mtilocca/sprinkler-valve-controller/README.md

# Sprinkler Valve Controller — ESP32-S3, 12 V in, 4 valves, isolated RS485

**Status:** Rev C (adds LoRa): schematic ERC clean, board routed and DRC clean (0 errors, 0 unconnected), fab files generated. Order in progress. This project is the simplified successor of the MPPT board (`../sprinkler-mppt-pcb`): PV and MPPT moved to a separate module.

## What it is

A small board that runs 4 sprinkler valves from a 12 V supply (battery, the PV/MPPT module, or a wall adapter; never above 15 V).

- **ESP32-S3-WROOM-1-N8**, firmware on Zephyr RTOS
- **4 valve outputs** (12 V, up to 1 A each, at most 2 on at once)
- **LoRa EU868** (Ebyte E22-900M22S, SX1262), single-channel gateway for your own sensors
- **WiFi and Bluetooth LE** from the ESP32-S3 module
- **Isolated RS485** (CA-IS3092W) for Modbus RTU
- **USB-C** for flashing, BOOT and RESET buttons, debug header, 4 LEDs
- **12 V monitor** into the ESP32 ADC, so the firmware can stop the valves on a low battery
- **Input protection:** resettable fuse, reverse-polarity P-FET, TVS

Target board: 100 × 60 mm, 2 layers, all SMT parts on the top, only screw terminals and headers through-hole.
Radio: Ebyte E22-900M22S (SX1262, EU 868 MHz) single-channel LoRa gateway radio with a u.FL antenna connector, see docs/08-fabrication.md (Rev C).

## Documents

| File | Content |
|---|---|
| [docs/01-requirements.md](docs/01-requirements.md) | Requirements and assumptions |
| [docs/02-hardware.md](docs/02-hardware.md) | Power tree, valves, RS485, USB-C, protection |
| [docs/03-pinmap.md](docs/03-pinmap.md) | ESP32-S3 GPIO map |
| [docs/04-firmware.md](docs/04-firmware.md) | Firmware notes |
| [docs/06-bringup.md](docs/06-bringup.md) | Bring-up and test plan |
| [docs/07-parts-check.md](docs/07-parts-check.md) | Web check of the risky parts, LCSC numbers, risks |
| [docs/08-fabrication.md](docs/08-fabrication.md) | JLCPCB order settings, files, checks |
| [docs/09-shopping-list.md](docs/09-shopping-list.md) | Hand-soldered parts and other things to buy |
| [docs/10-board-layout.md](docs/10-board-layout.md) | Board layout, capabilities, layout rules, bring-up notes |
| [hardware/README.md](hardware/README.md) | How the schematic and board are generated |

## Schematic

PDF: [hardware/valve_controller_schematic.pdf](hardware/valve_controller_schematic.pdf). Generated from `hardware/valve_controller.py` (SKiDL); open `hardware/valve_controller.kicad_pro` in KiCad.

| Sheet | Content |
|---|---|
| `power_in` | 12 V terminal, fuse, reverse-polarity P-FET, TVS, 12 V monitor divider |
| `aux_power` | AP63205 5 V buck, USB 5 V OR, AMS1117-3.3 LDO (22 µF tantalum output) |
| `esp32` | ESP32-S3 module, BOOT and RESET, debug header |
| `usb_c` | USB-C connector, CC resistors, ESD protection |
| `lora` | E22-900M22S LoRa module, decoupling, u.FL antenna connector |
| `valves` | 4 × AO3400A drivers with flyback diodes, screw terminals, bulk capacitor |
| `rs485` | CA-IS3092W, TVS, termination and bias jumpers, terminal |
| `leds` | 4 LEDs and resistors |
| `test_points` | V12, 5V, 3V3, GND |

## Board

Open `hardware/valve_controller.kicad_pcb` (or the project `hardware/valve_controller.kicad_pro`) in KiCad 10. Layout notes: [docs/10-board-layout.md](docs/10-board-layout.md).

### 3D views

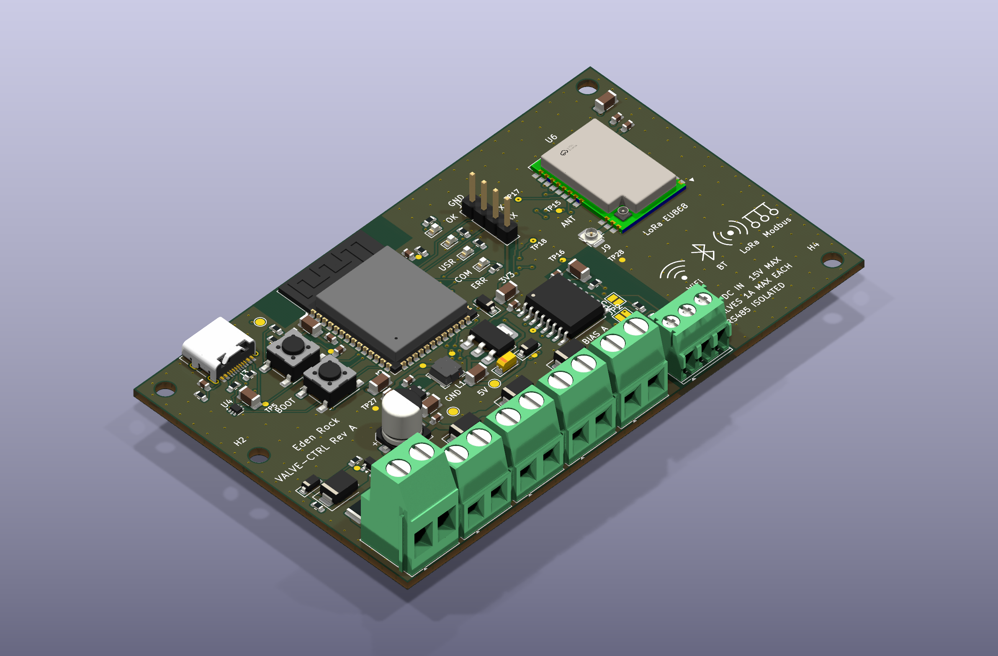
[picture p1: docs/images/board-3d-iso-revc.png]
3D view, isometric


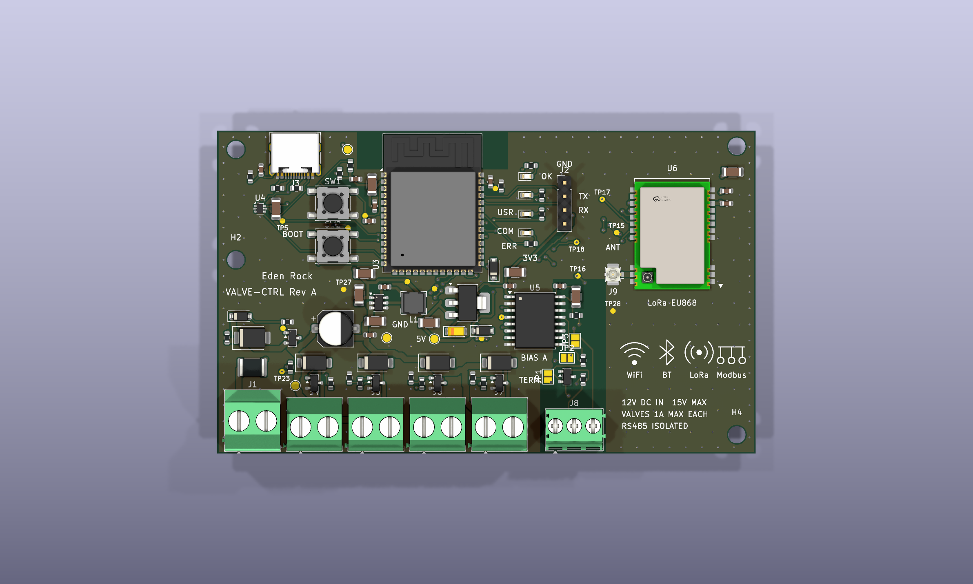
[picture p2: docs/images/board-3d-top-revc.png]
3D view, top


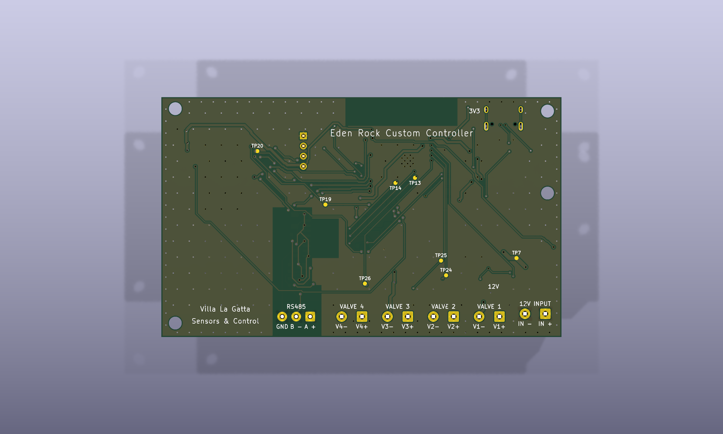
[picture p3: docs/images/board-3d-bottom-revc.png]
3D view, bottom


### Layout

Top side with silkscreen:

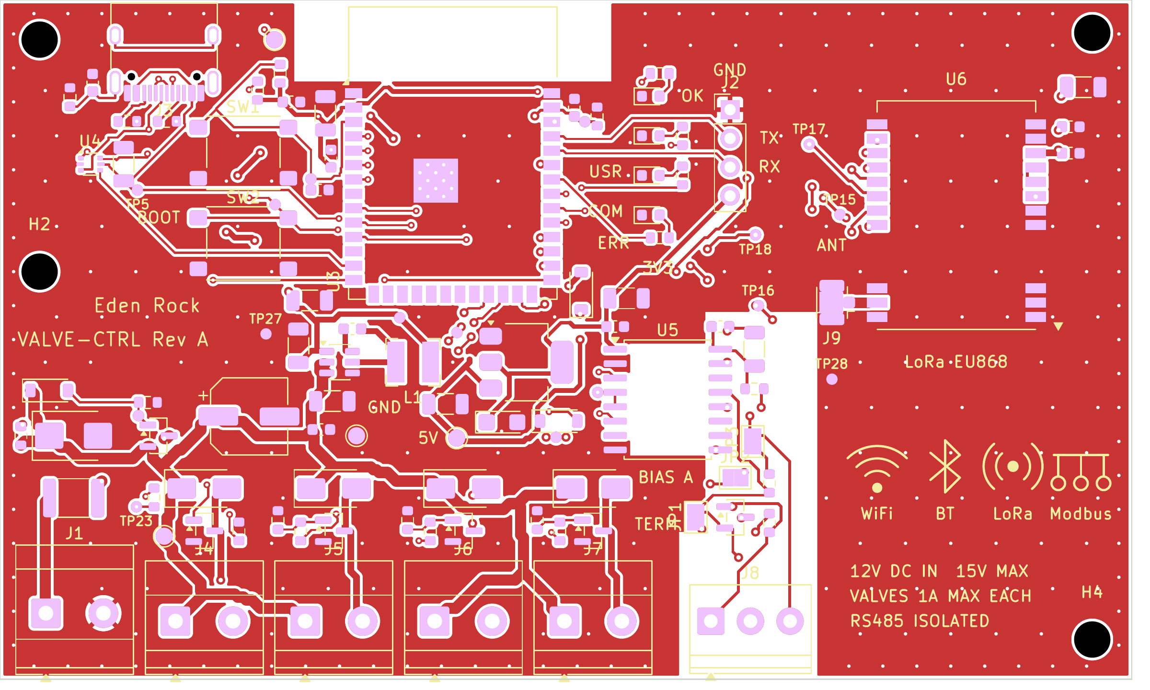
[picture p4: docs/images/board-layout-top-revc.png]
Board layout, top


Both copper layers (red = top, blue = bottom, GND pours on both):

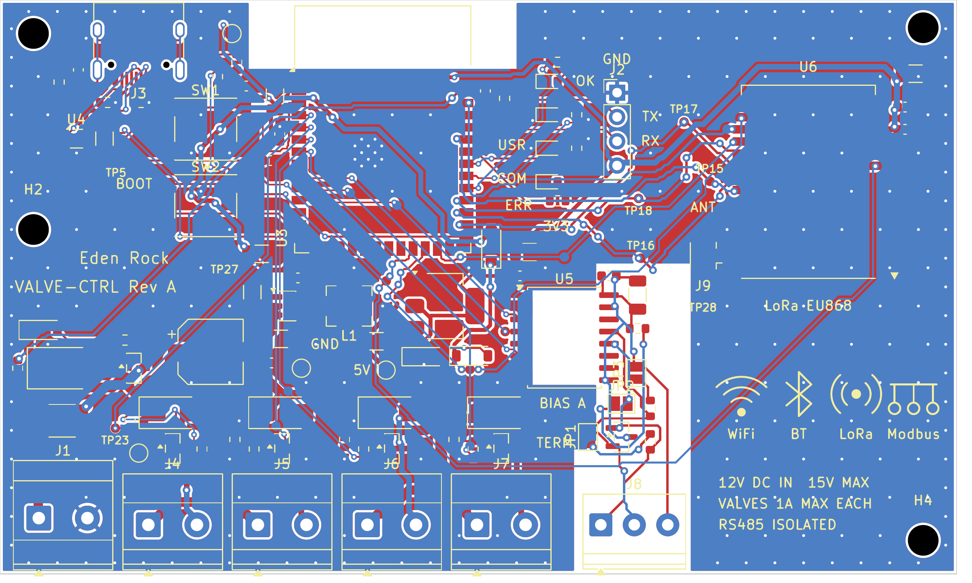
[picture p5: docs/images/board-copper-revc.png]
Copper layers


### Schematic sheets

The schematic is generated label-only (nets are connected by name, see `hardware/README.md`). Full PDF: [hardware/valve_controller_schematic.pdf](hardware/valve_controller_schematic.pdf).

| Sheet | Image |
|---|---|
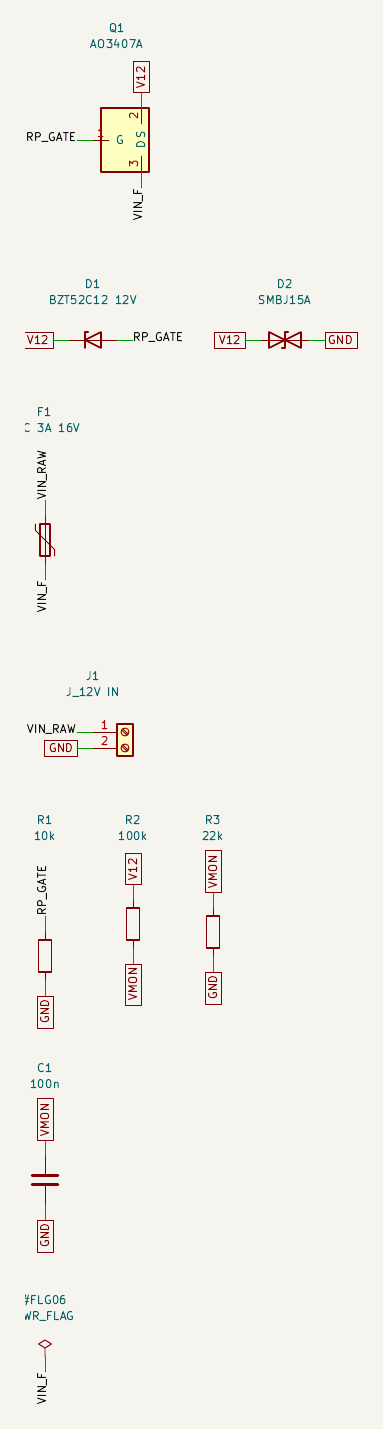
[picture p6: docs/images/schematic-power_in.png]
power_in
| `power_in` |  |
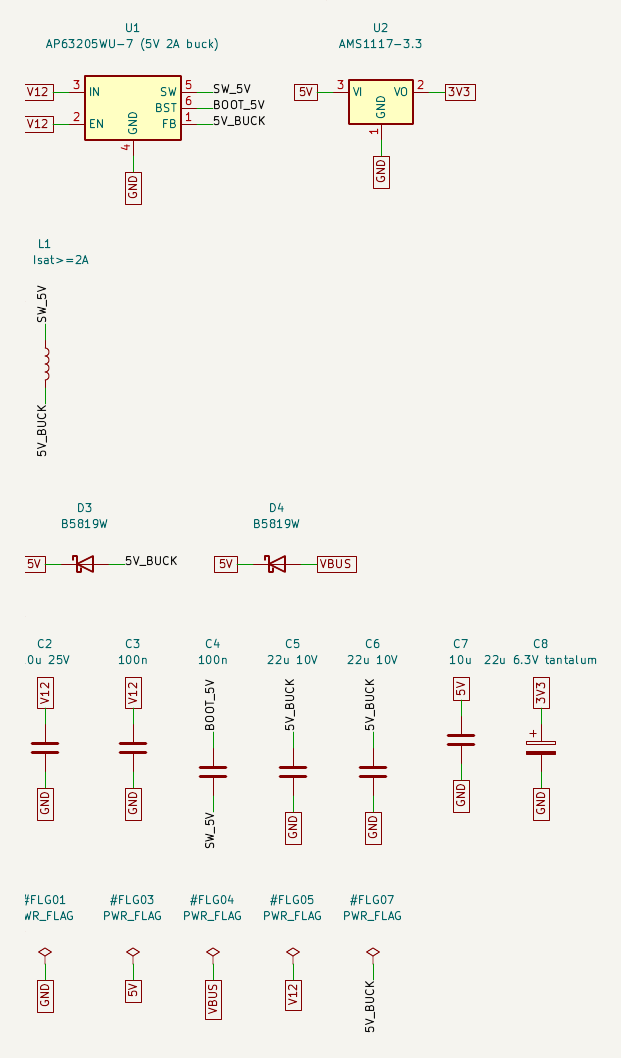
[picture p7: docs/images/schematic-aux_power.png]
aux_power
| `aux_power` |  |
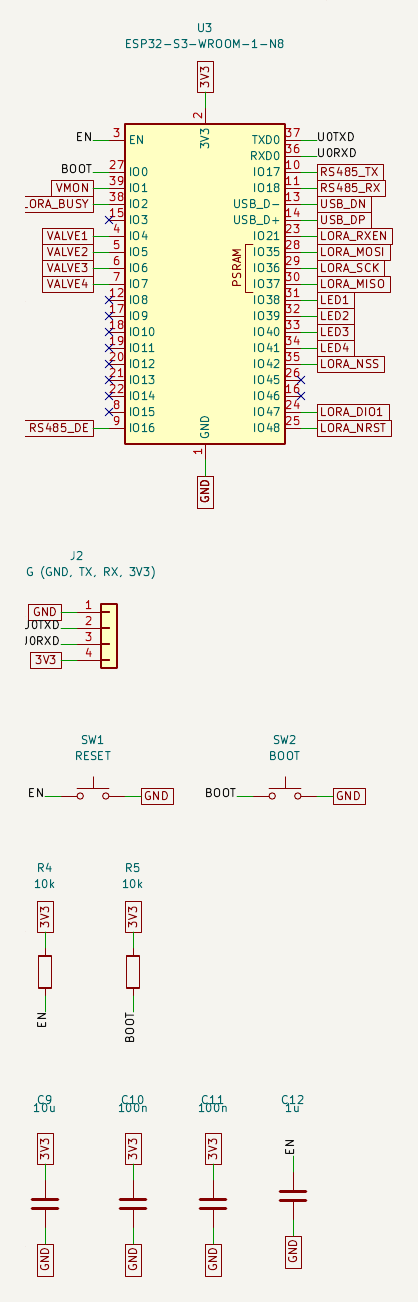
[picture p8: docs/images/schematic-esp32.png]
esp32
| `esp32` |  |
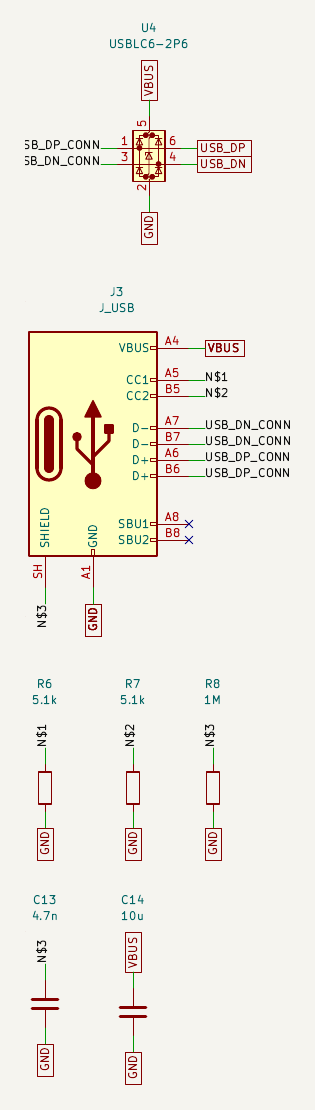
[picture p9: docs/images/schematic-usb_c.png]
usb_c
| `usb_c` |  |
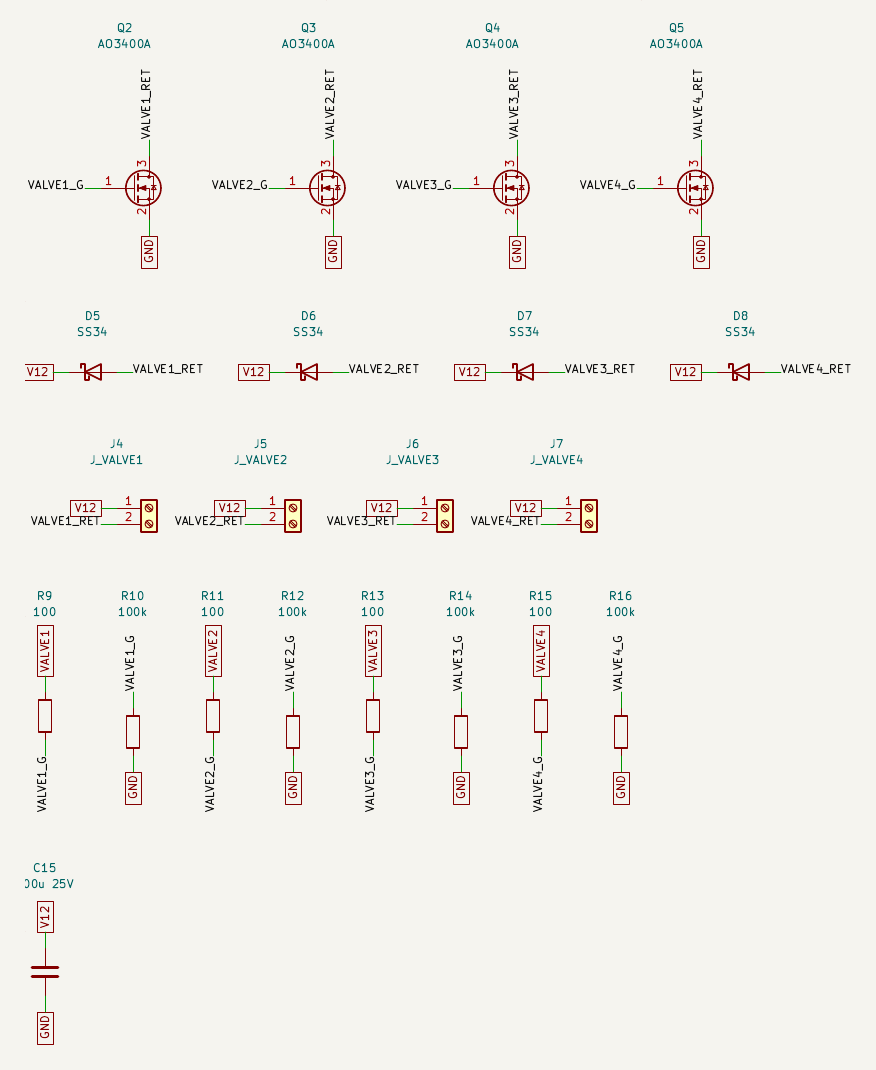
[picture p10: docs/images/schematic-valves.png]
valves
| `valves` |  |
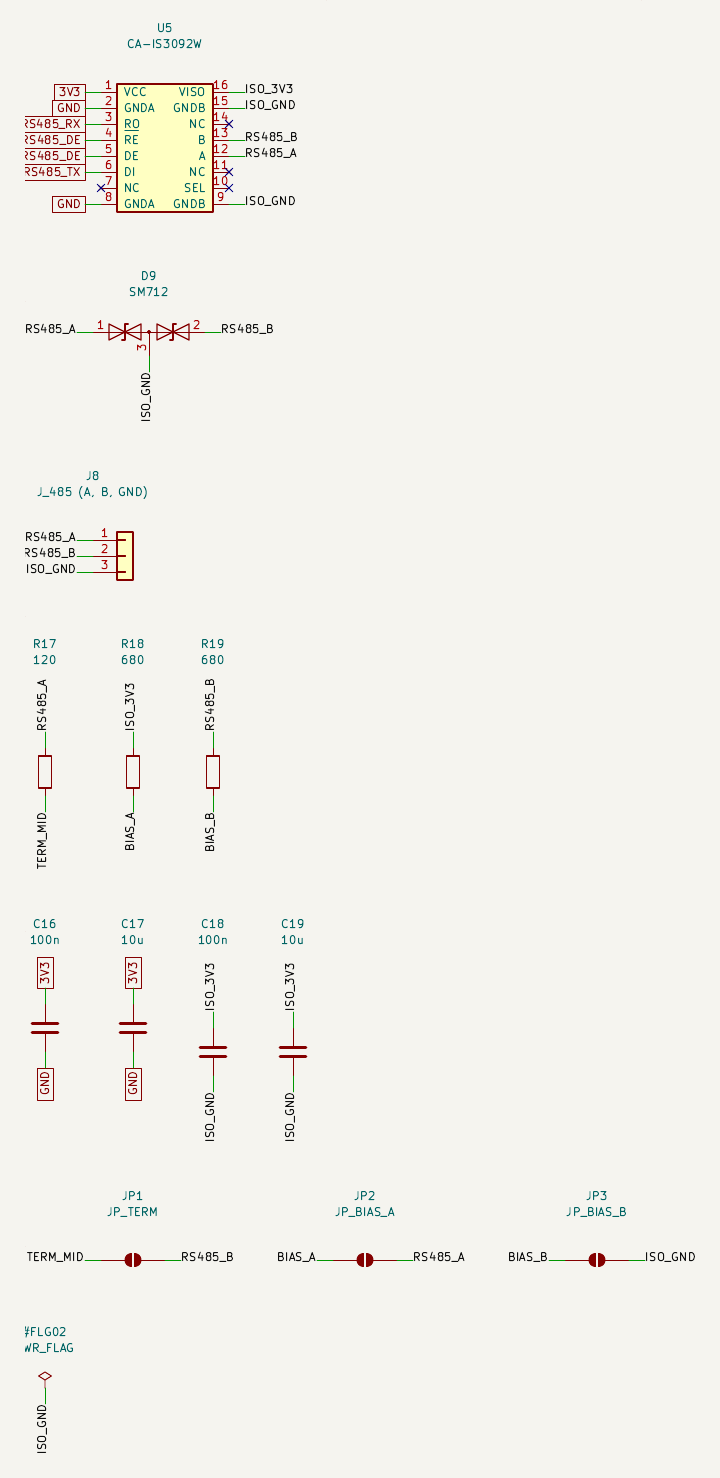
[picture p11: docs/images/schematic-rs485.png]
rs485
| `rs485` |  |
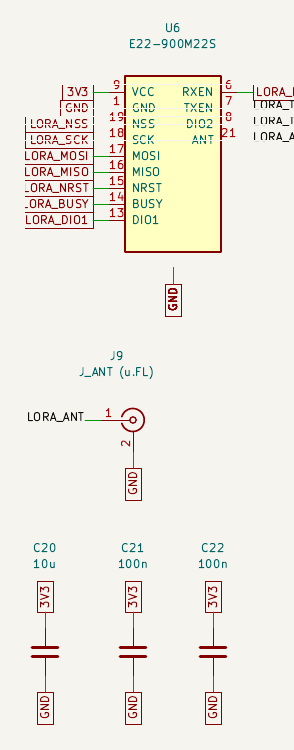
[picture p12: docs/images/schematic-lora.png]
lora
| `lora` |  |
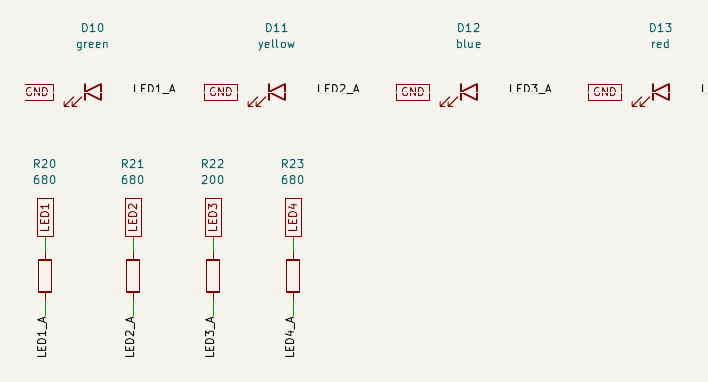
[picture p13: docs/images/schematic-leds.png]
leds
| `leds` |  |
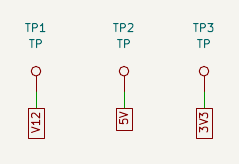
[picture p14: docs/images/schematic-test_points.png]
test_points
| `test_points` |  |

## Fabrication specs

| Item | Value |
|---|---|
| Size | 100 x 60 mm, 4 x M3 mounting holes |
| Layers | 2, GND pour on both layers with stitching vias |
| Copper, finish | 1 oz, HASL lead-free (ENIG optional) |
| Track and space | 0.2 / 0.2 mm; V12 rail 1.0 mm, valve returns 0.6 mm, 5 V rails 0.5 mm |
| Vias | 0.6 / 0.3 mm |
| Antenna area | No copper in the strip at the top edge around the ESP32 antenna |
| RS485 isolation | Bus side right of the isolator: no GND pour, nothing under the chip body between the pin rows (about 7 mm) |
| Assembly | One side (top), SMT by JLCPCB; screw terminals and the debug header soldered by hand |
| Checks | ERC 0 violations; DRC 0 errors, 0 unconnected |

Files in `hardware/fab/`: `gerbers_valve_controller_RevC.zip` (and `gerber/`), `BOM_valve_controller.csv` (draft with suggested parts and rough prices), `BOM_JLCPCB_import.csv` (LCSC numbers to fill), `CPL_valve_controller.csv` (SMD positions, top side).

## Costs

**Rough estimates from memory, not quotes.** Upload the files to the JLCPCB quote page for real numbers. USD.

| Item | Estimate |
|---|---|
| Components per board | about 14 (84 parts, 15 of the BOM lines are JLCPCB "extended" parts) |
| 5 bare 2-layer boards | about 2-8 |
| Shipping | 15-25 |
| JLCPCB SMT assembly fees (one side) | about 55-65 (setup, stencil, about 3 per extended part type) |
| **5 boards assembled by JLCPCB** (terminals and header soldered by hand) | **about 150-180, roughly 30-35 per board** |
| **2 boards assembled** | about 100-120 |
| **2 boards built entirely by hand** | about 50-70 (boards, shipping, parts) |

Open items before ordering: confirm stock and basic/extended class on the JLCPCB parts pages for the LCSC numbers in the BOM (see docs/07-parts-check.md), especially the LDO (low stock seen); the PTC fuse hold current drops when hot; two small silkscreen labels did not fit (RESET, BIAS B); terminal polarity labels are on the bottom side, next to the pads.
