mtilocca/sprinkler-valve-controller/hardware/erc_report.txt

ERC report (2026-11-01T22:34:55, Encoding UTF8)
Report includes: Errors, Warnings, Exclusions

***** Sheet /

***** Sheet /power_in/

***** Sheet /aux_power/

***** Sheet /esp32/

***** Sheet /usb_c/

***** Sheet /valves/

***** Sheet /rs485/

***** Sheet /leds/

***** Sheet /test_points/

***** Sheet /lora/

 ** ERC messages: 0  Errors 0  Warnings 0

 ** Ignored checks:
    - Global label only appears once in the schematic
    - Four connection points are joined together
    - SPICE model issue
    - Assigned footprint doesn't match footprint filters
