mtilocca/sprinkler-valve-controller/hardware/3d/top_render_lora.png

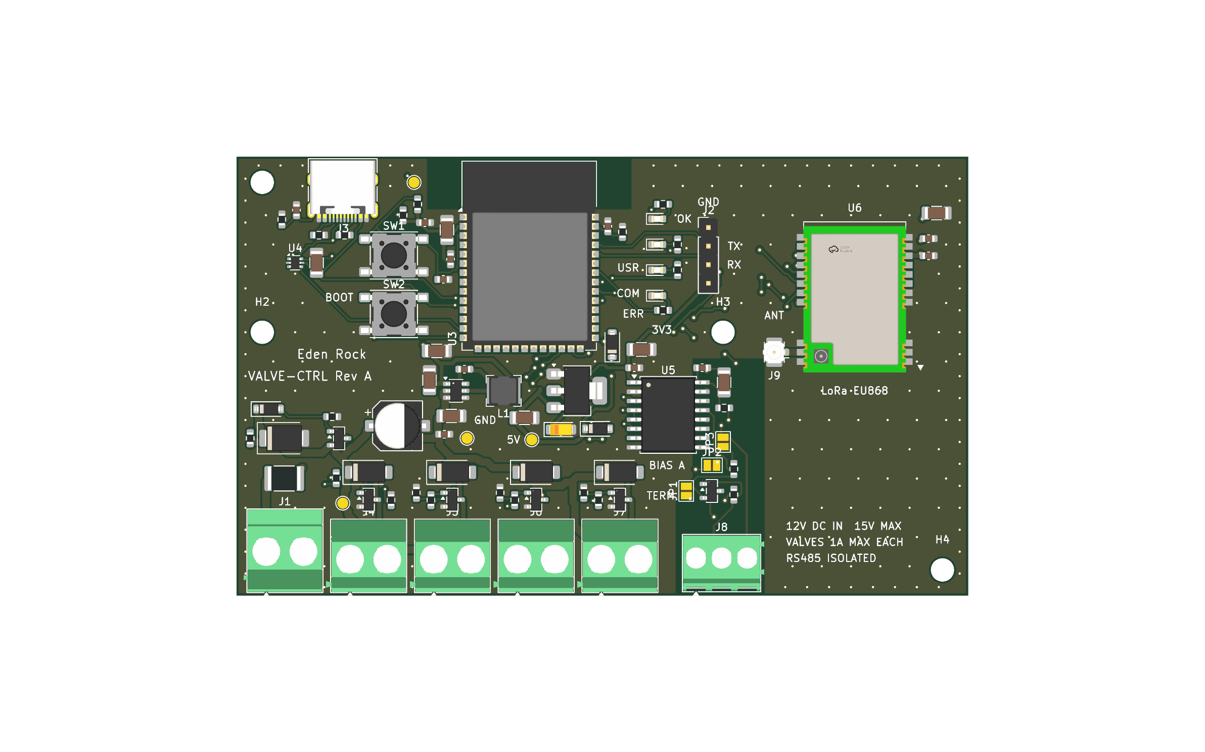
hardware/3d/top_render_lora.png
