mtilocca/sprinkler-valve-controller/hardware/3d/top_render_with_usb.png

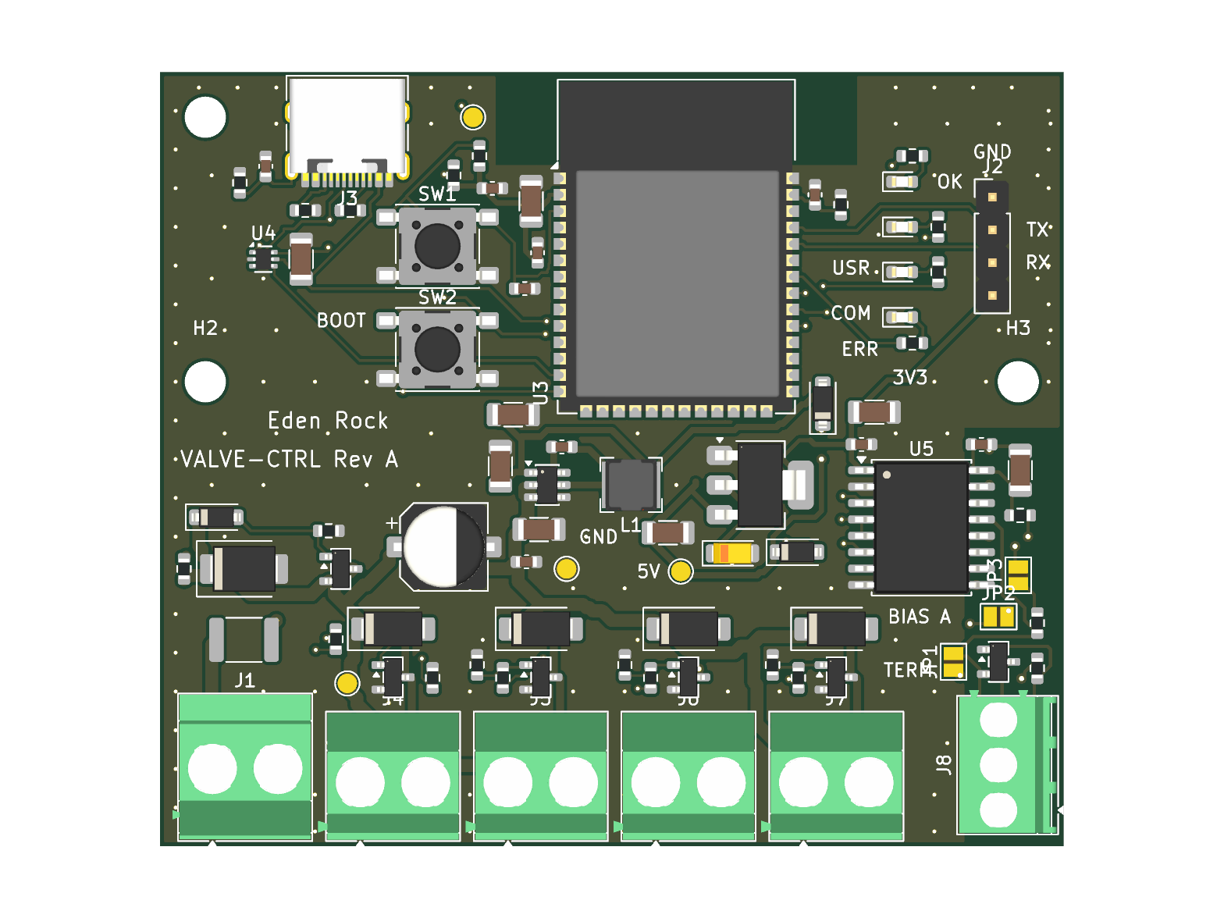
hardware/3d/top_render_with_usb.png
