mtilocca/sprinkler-valve-controller/hardware/fab/BOM_JLCPCB_import.csv

Comment | Designator | Footprint | LCSC Part #
100n | C1,C3,C4,C10,C11,C16,C18,C21,C22 | C_0603_1608Metric | C14663
10u 25V | C2 | C_1206_3216Metric | C13585
22u 10V | C5,C6 | C_1206_3216Metric | C12891
10u | C7,C9,C14,C17,C19,C20 | C_1206_3216Metric | C13585
22u 6.3V tantalum | C8 | CP_EIA-3216-18_Kemet-A | C11366
1u | C12 | C_0603_1608Metric | C15849
4.7n | C13 | C_0603_1608Metric | C53987
100u 25V | C15 | CP_Elec_6.3x7.7 | C72478
BZT52C12 12V | D1 | D_SOD-123 | C19077410
SMBJ15A | D2 | D_SMB | C188412
B5819W | D3,D4 | D_SOD-123 | C64885
SS34 | D5,D6,D7,D8 | D_SMA | C8678
SM712 | D9 | SOT-23 | C5364052
green | D10 | LED_0603_1608Metric | C12624
yellow | D11 | LED_0603_1608Metric | C2287
blue | D12 | LED_0603_1608Metric | C2288
red | D13 | LED_0603_1608Metric | C2286
PTC 3A 16V | F1 | Fuse_1812_4532Metric | C6851473
J_USB | J3 | USB_C_Receptacle_HRO_TYPE-C-31-M-12 | C165948
J_ANT (u.FL) | J9 | U.FL_Hirose_U.FL-R-SMT-1_Vertical | C88374
4.7u Isat>=2A | L1 | L_Bourns-SRN4018 | C167806
AO3407A | Q1 | SOT-23 | C347478
AO3400A | Q2,Q3,Q4,Q5 | SOT-23 | C20917
10k | R1,R4,R5 | R_0603_1608Metric | C25804
100k | R2,R10,R12,R14,R16 | R_0603_1608Metric | C25803
22k | R3 | R_0603_1608Metric | C31850
5.1k | R6,R7 | R_0603_1608Metric | C23186
1M | R8 | R_0603_1608Metric | C22935
100 | R9,R11,R13,R15 | R_0603_1608Metric | C22775
120 | R17 | R_0603_1608Metric | C22787
680 | R18,R19,R20,R21,R23 | R_0603_1608Metric | C23228
200 | R22 | R_0603_1608Metric | C8218
RESET | SW1 | SW_SPST_PTS645Sx43SMTR92 | C221880
BOOT | SW2 | SW_SPST_PTS645Sx43SMTR92 | C221880
AP63205WU-7 (5V 2A buck) | U1 | TSOT-23-6 | C2071056
AMS1117-3.3 | U2 | SOT-223-3_TabPin2 | C6186
ESP32-S3-WROOM-1-N8 | U3 | ESP32-S3-WROOM-1 | C2913198
USBLC6-2P6 | U4 | SOT-666 | C2827693
CA-IS3092W | U5 | SOIC-16W_7.5x10.3mm_P1.27mm | C2890051
E22-900M22S | U6 | E22-900M22S | C411293
