mtilocca/sprinkler-valve-controller/hardware/3d/E22-900M22S.step

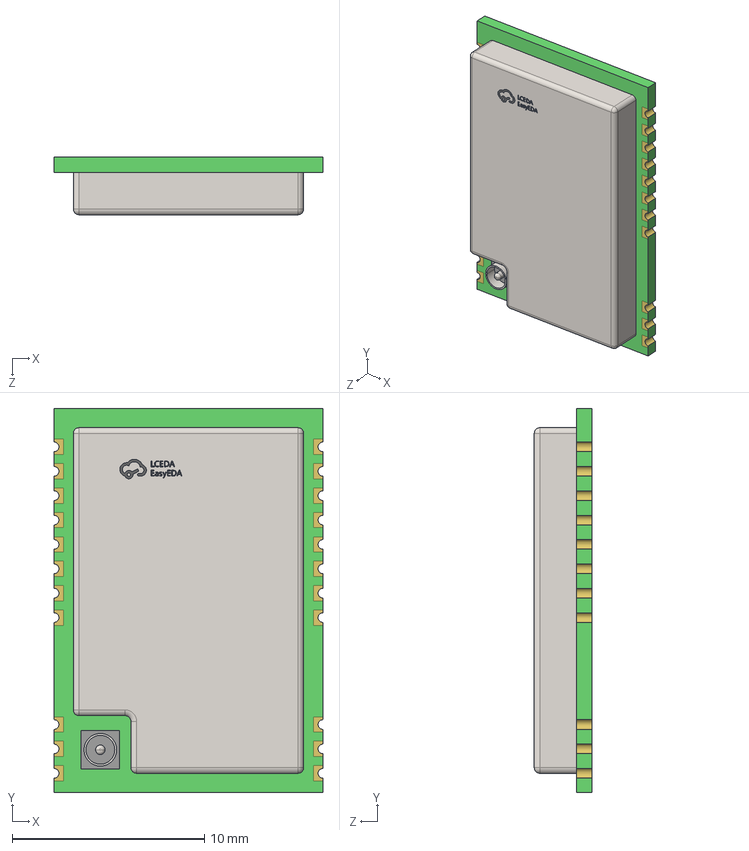
[picture p17: CAD file, 2026-11-01]
hardware/3d/E22-900M22S.step
14.0 x 20.0 x 3.00 mm
