mtilocca/sprinkler-valve-controller/hardware/3d/Fuse_1812_4532Metric.step

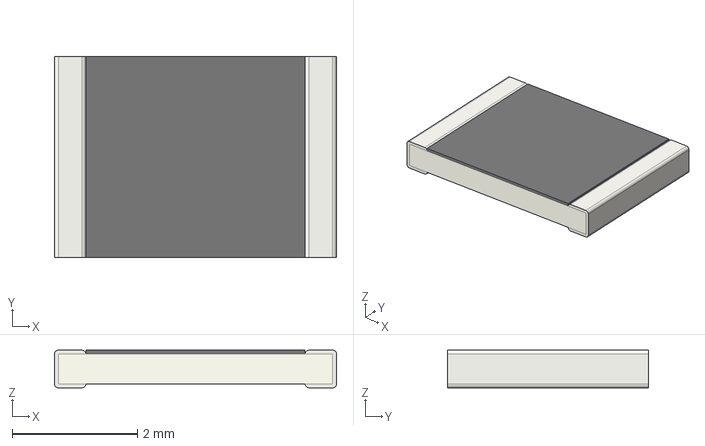
[picture p18: CAD file, 2026-11-01]
hardware/3d/Fuse_1812_4532Metric.step
4.50 x 3.20 x 0.6 mm
