mtilocca/sprinkler-valve-controller/hardware/3d/USB_C_HRO_TYPE-C-31-M-12.step

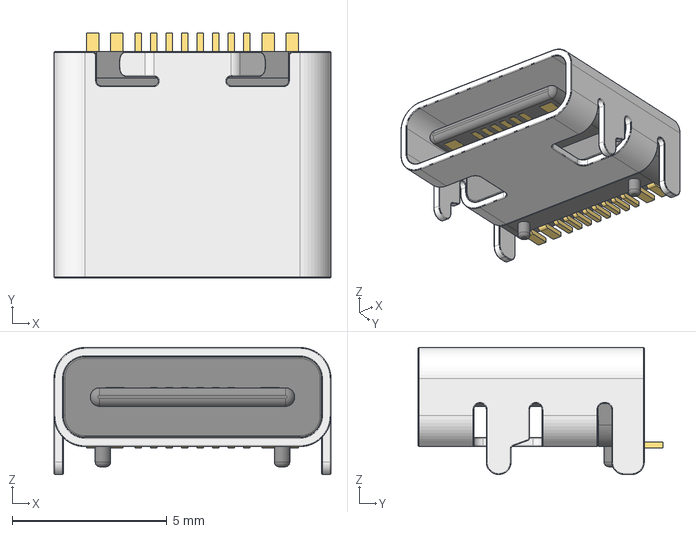
[picture p19: CAD file, 2026-11-01]
hardware/3d/USB_C_HRO_TYPE-C-31-M-12.step
8.94 x 7.90 x 4.10 mm
