mtilocca/sprinkler-valve-controller/docs/08-fabrication.md

# 8. Fabrication and assembly (JLCPCB)

Everything for the order is in `hardware/fab/`.

## Files

| File | Use |
|---|-----|
| `gerbers_valve_controller_RevC.zip` | Upload as the PCB Gerber file (also unpacked in `gerber/`): F.Cu, B.Cu, masks, silkscreen, F.Paste, Edge.Cuts, PTH and NPTH drill |
| `BOM_JLCPCB_import.csv` | Upload as the BOM for assembly: 38 lines, surface-mount parts only (you solder the terminals and header). Ordinary resistors and capacitors have no LCSC number: JLCPCB's matching picks the basic parts |
| `CPL_valve_controller.csv` | Upload as the pick-and-place file: 70 SMD parts, top side |
| `BOM_valve_controller.csv` | Full draft BOM with suggested parts, rough prices and notes (for you, not for upload) |
| `assembly_top.pdf`, `assembly_bottom_labels.pdf` | Assembly drawings: where parts go; terminal labels on the bottom side |
| `valve_controller_schematic.pdf` | Schematic |

## Board settings to choose on the order page

| Setting | Value |
|---|---|
| Base material, layers | FR-4, 2 layers |
| Dimensions | 100 x 60 mm |
| PCB thickness | 1.6 mm |
| Quantity | 5 (smallest panel; the cheapest) |
| Surface finish | HASL lead-free (ENIG optional, small extra cost) |
| Outer copper | 1 oz |
| Solder mask, silkscreen | any colour; white silkscreen |
| Via covering | tented (default) |
| Order number on the board | JLCPCB prints a small order number on the silkscreen; accept the default, or pay the small fee to remove it (there is no placeholder text on this board) |

Board rules used: tracks and gaps 0.2 mm, smallest drill 0.3 mm (the ESP32 pad vias were enlarged from 0.2 to 0.3 mm because 0.2 mm is not available on 2 layers), copper 0.3 mm from the edge, hole to hole 0.5 mm.

## Assembly settings

| Setting | Value |
|---|---|
| PCBA type | **Standard** (the ESP32 module is "Standard only") |
| Assembly side | Top only |
| Quantity | 2 or 5 (minimum 2) |
| Parts | Upload the BOM and CPL. Check every line in JLCPCB's part selection: stock and basic/extended class |
| Through-hole | Not in the BOM or CPL: you solder J1, J4-J7 (5.08 mm terminals), J8 (3.5 mm terminal) and J2 (debug header) yourself: 17 pins per board |
| Solder jumpers | JP1-JP3 stay open (no part) |

## Check in JLCPCB's preview before paying

1. **Part rotations.** JLCPCB's pick-and-place preview shows each part on the board; rotate or flip wrong ones there. The usual suspects are SOT-23 parts (Q1-Q5, D9), the SOT-223 LDO (U2), the SOIC-16 RS485 chip (U5), the TSOT-23-6 buck (U1), the SOT-666 ESD part (U4), the diodes (polarity!) and the ESP32 module (U3).
2. **Stock.** Check C15 (100 µF electrolytic) and D2 (SMBJ15A): both were out of stock on the first match; pick in-stock alternatives (docs/07-parts-check.md). The tantalum C8 (22 µF 6.3 V, 3216) has no LCSC number in the BOM: pick one in the search.
3. **Polarity parts.** Check the cathode side of D1-D8, the zener and the LEDs against `assembly_top.pdf`, and the + side of the electrolytic C15.
4. **Antenna.** The ESP32 antenna end must face the board edge (top edge in the 3D view).

## After the boards arrive

Solder the terminals and header by hand (parts list in docs/09-shopping-list.md), then follow `docs/06-bringup.md`.

## Verified before export

- ERC: 0 violations. DRC: 0 errors, 0 unconnected, schematic parity clean (warnings only for test points, jumpers and mounting holes).
- Outline from the Gerber file: 70.0 x 60.0 mm. Drill file: all plated holes at least 0.3 mm.
- Every part in the CPL is in the BOM; the only BOM lines not in the CPL are the hand-soldered terminals and header.

## CPL correction for U3 (2026-11-01)

In JLCPCB's 3D preview the ESP32 module sat about 4 mm too high (antenna past the board edge, castellations not on the pads). JLCPCB's model origin differs from the KiCad footprint origin, so U3's Y in `CPL_valve_controller.csv` was changed from -13.5 mm to -17.5 mm. The board itself is unchanged. Re-check the preview after uploading the new CPL.

## CPL rotations (2026-11-01)

JLCPCB's models for U2 (SOT-223) and U5 (SOIC-16W) are rotated against the KiCad footprints: U2 set to 180 deg, U5 to 270 deg in the CPL. Verified only against the 3D preview; check pin 1 again after uploading.

## Rev C: LoRa radio (2026-11-02)

New requirement: a LoRa gateway for the sensors around the site (EU 868 MHz). Single-channel only: JLCPCB does not stock SX1302/SX1303 concentrator chips, so this is a private single-channel receiver, not a standards-compliant multi-channel LoRaWAN gateway. Your own sensors must be set to the one channel and data rate that the radio listens on.

- Radio: Ebyte E22-900M22S (SX1262, 868 MHz, 22 dBm), LCSC C411293, SPI plus BUSY, DIO1, NRST and RXEN (see 03-pinmap.md). TXEN and DIO2 are wired together on the module, so the SX1262 drives the RF switch.
- Antenna: u.FL connector J9 (C88374) next to the module, a 2 mm trace from the module's ANT pad. You need a u.FL to SMA pigtail and an 868 MHz antenna. If the module has no signal on the ANT pad, plug the antenna into the module's own IPEX connector instead (the Ebyte datasheet lists both).
- Board: 100 x 60 mm (was 70 x 60), new mounting hole H4 (bottom right), H3 moved from mid-board to the top right corner (96.5, 2.9), E22 module at the right edge, 3V3 decoupling C20-C22.
- ESP32 pins used: GPIO2, 21, 35, 36, 37, 42, 47, 48.
- CPL: U3 was shifted 4 mm in Y, U2 rotated 180 and U5 270 against JLCPCB's models (see above). U6 and J9 are as exported: check them in the preview.
- Files regenerated with `python3 gen_fab.py RevC` (Gerbers, drill, CPL) and `make_bom.py` (BOM).
- DRC: 0 errors, 0 unconnected, schematic parity clean. ERC: 0 violations.
- J8 (RS485 terminal) rotated to face the bottom edge like the valve terminals; pads at x 62.8, 66.3 and 69.8 mm, y 54.9 mm (A, B, GND). The bus-side no-pour area is L-shaped around it. `move_j8.py` did the move. DRC 0 errors, 0 unconnected after the move.

## Pre-order review, 2026-11-02

- Found and fixed: the first LoRa routing ran the SPI lines and the 3V3 feed under the E22 module body (the Ebyte datasheet says to keep traces out from under the module). All eight signals and the 3V3 branch were re-routed around it; the only copper left under the body is GND and the TXEN/DIO2 tie at the pad edge. DRC 0 errors, 0 unconnected, parity clean.
- Checked from the netlist: P-FET reverse-polarity wiring (drain = input, source = load, 12 V zener gate to source, 10 k gate to GND), TVS and zener polarity, 5 V OR-ing diodes, 12 V monitor divider (max 2.7 V at 15 V), ESP32 strapping pins left alone, no floating nets other than the deliberate NC pins.
- Watch at bring-up: (1) on USB power only the 3V3 LDO input is about 4.6 V (5 V minus the Schottky), only about 0.2 V above the AMS1117 dropout at 0.6 A, so a LoRa transmit burst can sag 3V3; (2) the AMS1117 tab has no big copper area, fine for about 0.3 W average; (3) firmware must set DIO2 as RF switch control, RXEN high in receive, DIO3 for the module's TCXO (1.8 V).
