mtilocca/sprinkler-valve-controller/hardware/valve_controller_schematic.pdf

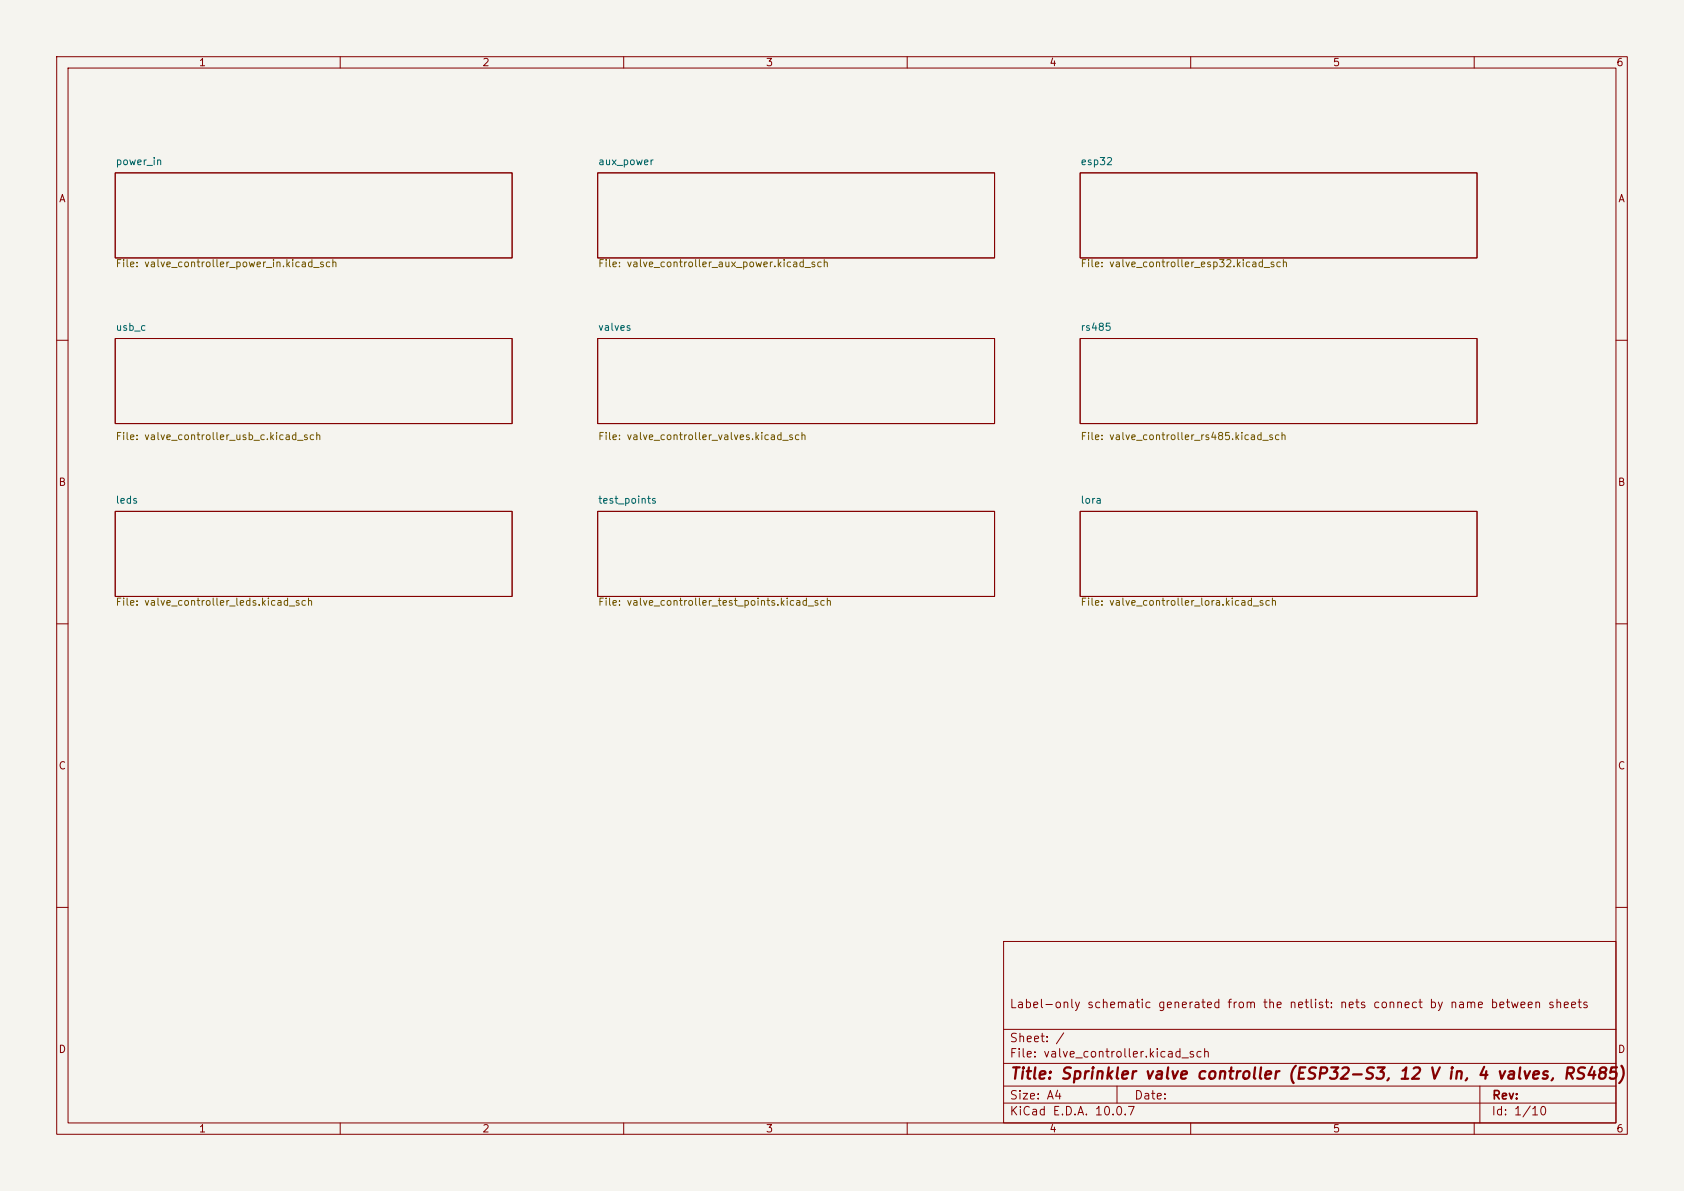
[picture p20: page 1]

Label-only schematic generated from the netlist: nets connect by name between sheets

Sheet: /
File: valve_controller.kicad_sch
Title: Sprinkler valve controller (ESP32-S3, 12 V in, 4 valves, RS485)

Size: A4 | Rev:
KiCad E.D.A. 10.0.7 | Id: 1/10

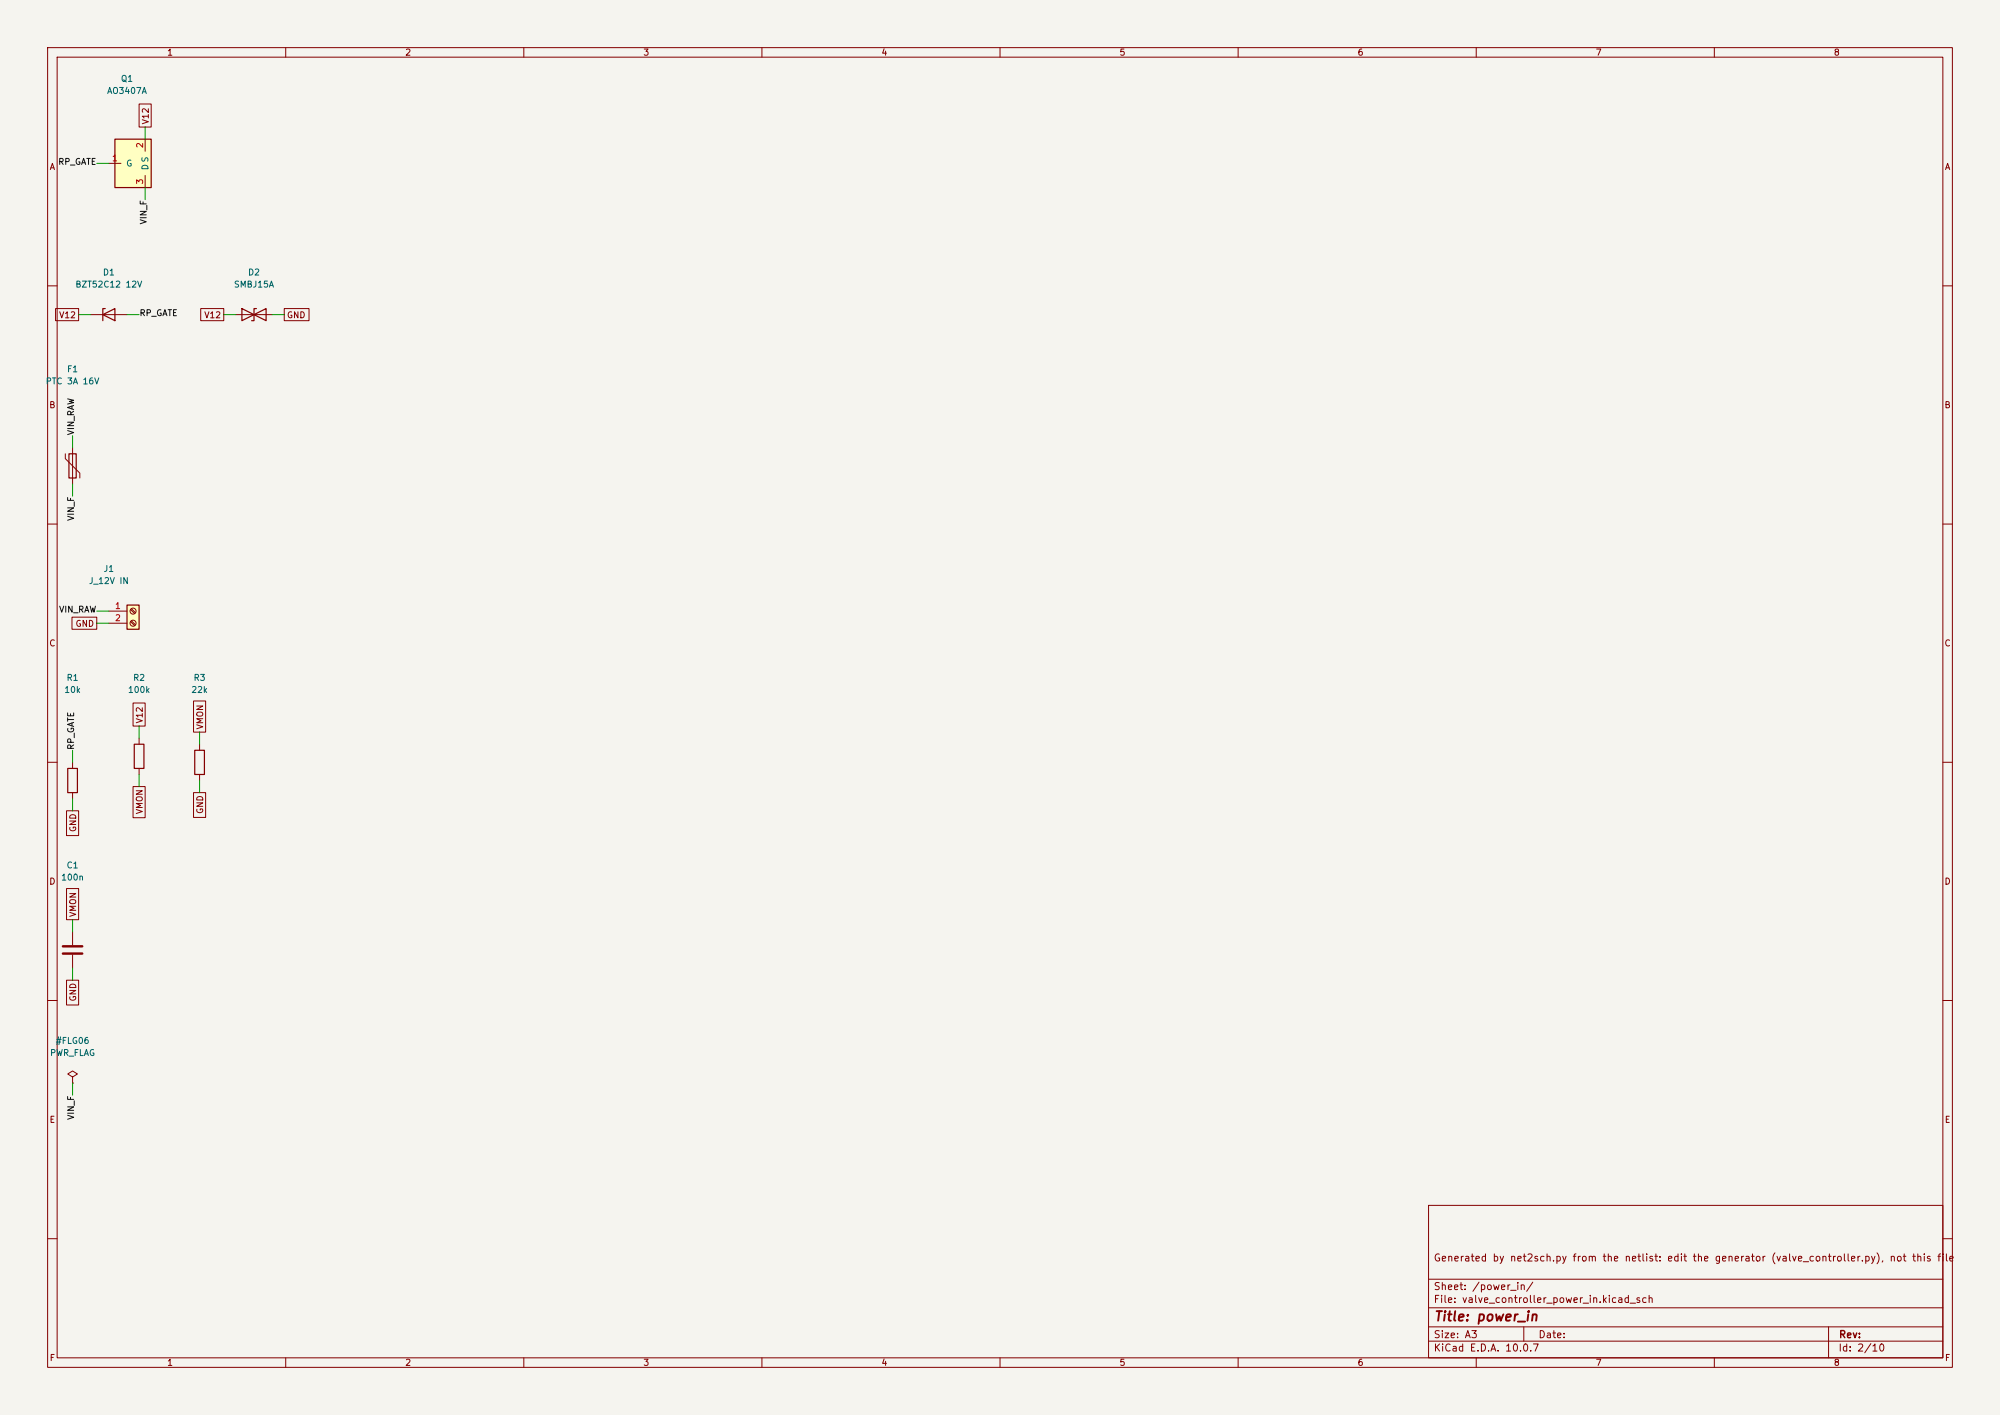
[picture p21: page 2]

Generated by net2sch.py from the netlist: edit the generator (valve_controller.py), not this file

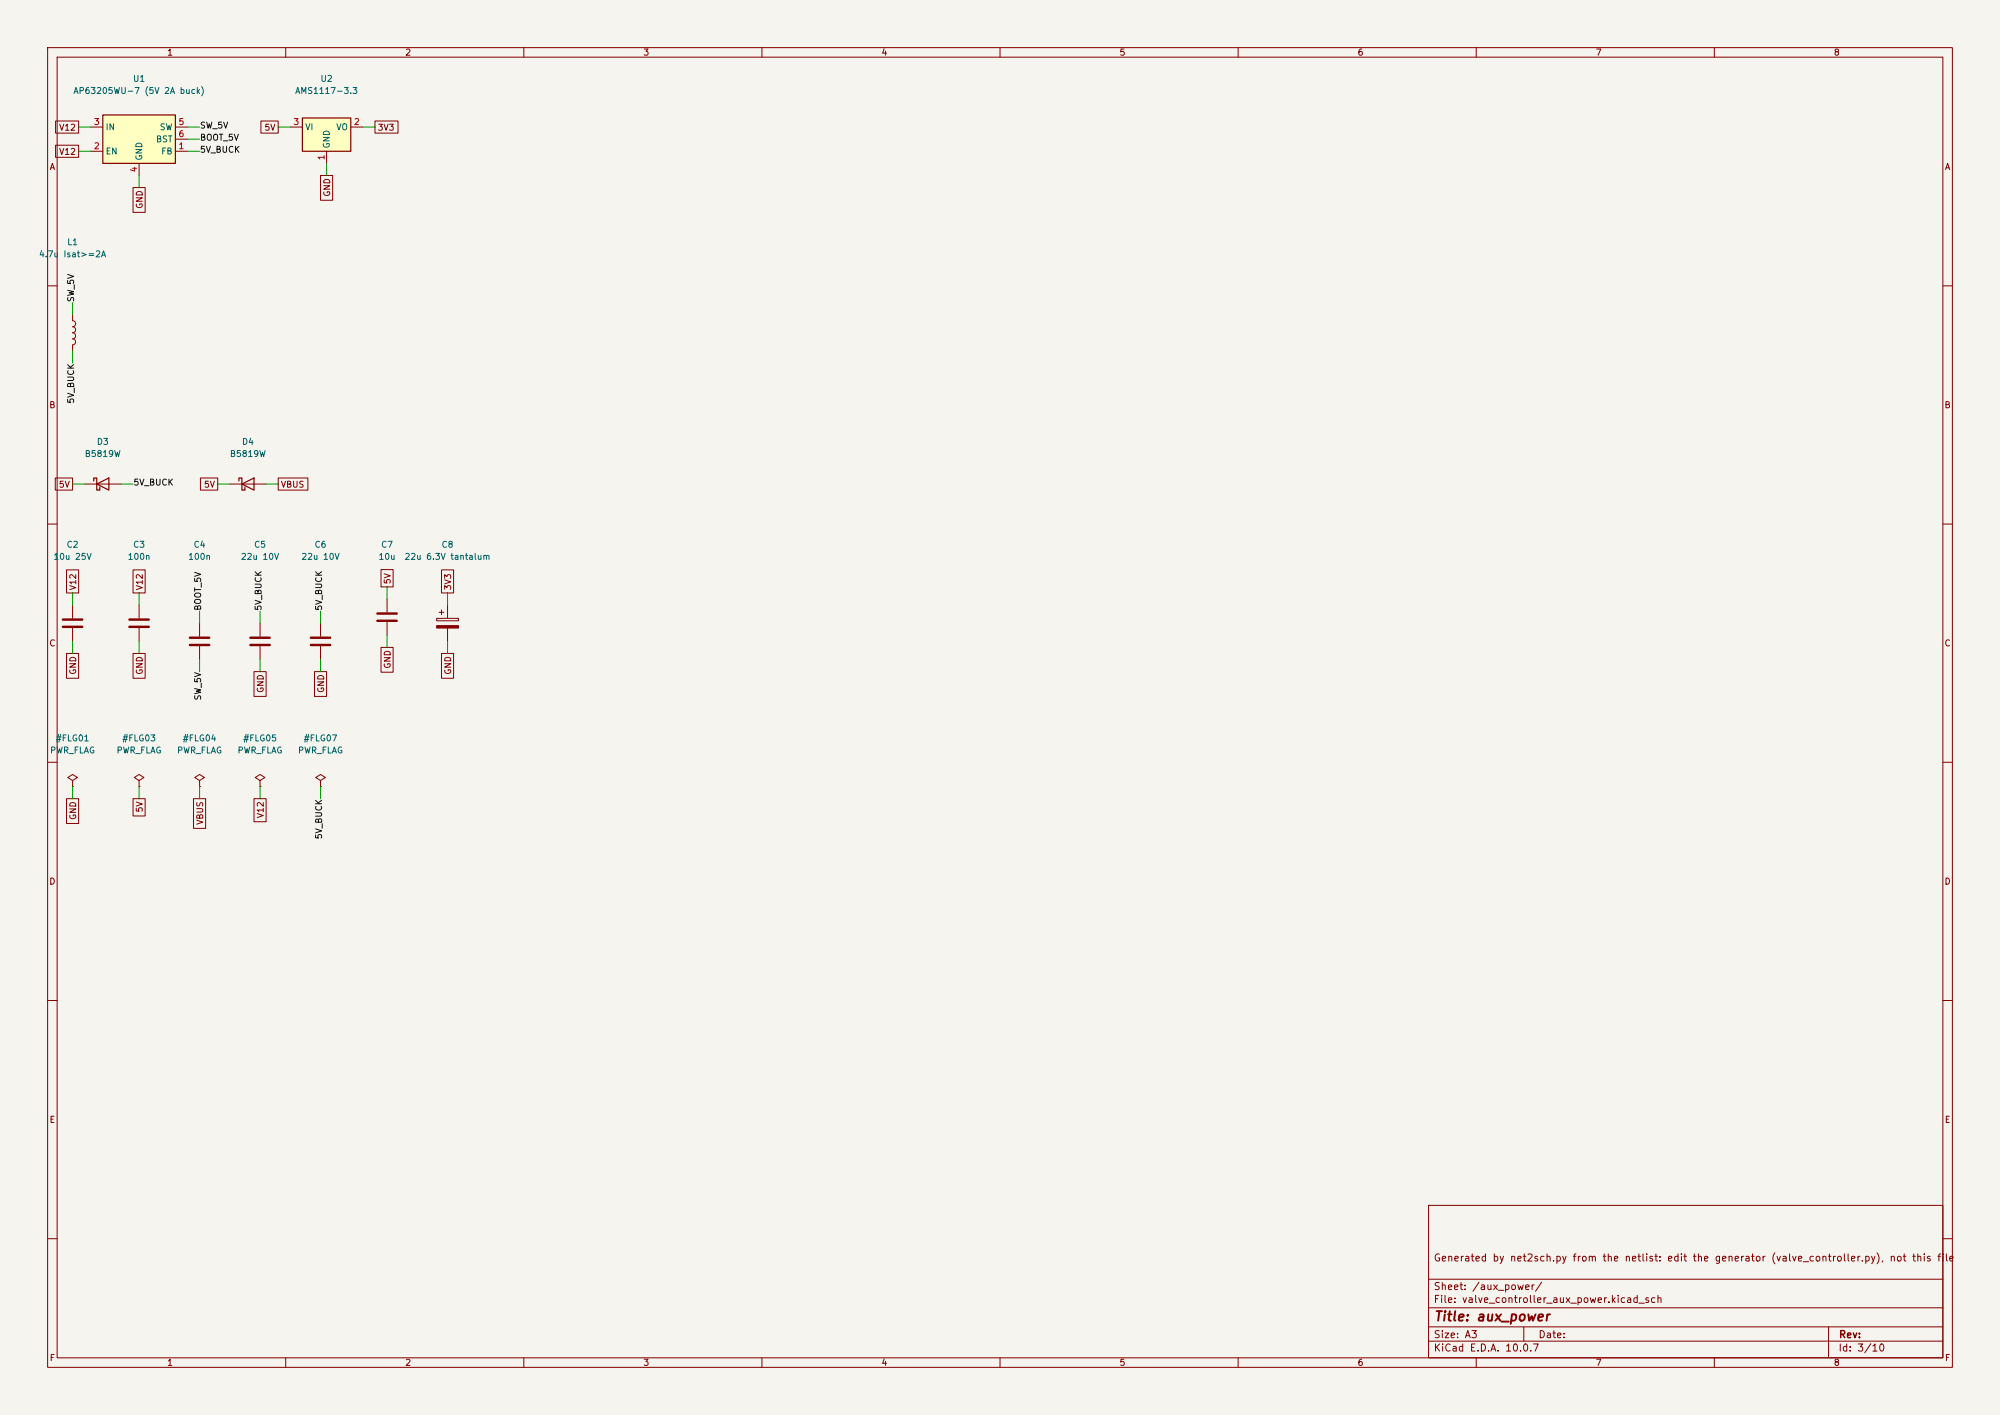
[picture p22: page 3]

Generated by net2sch.py from the netlist: edit the generator (valve_controller.py), not this file

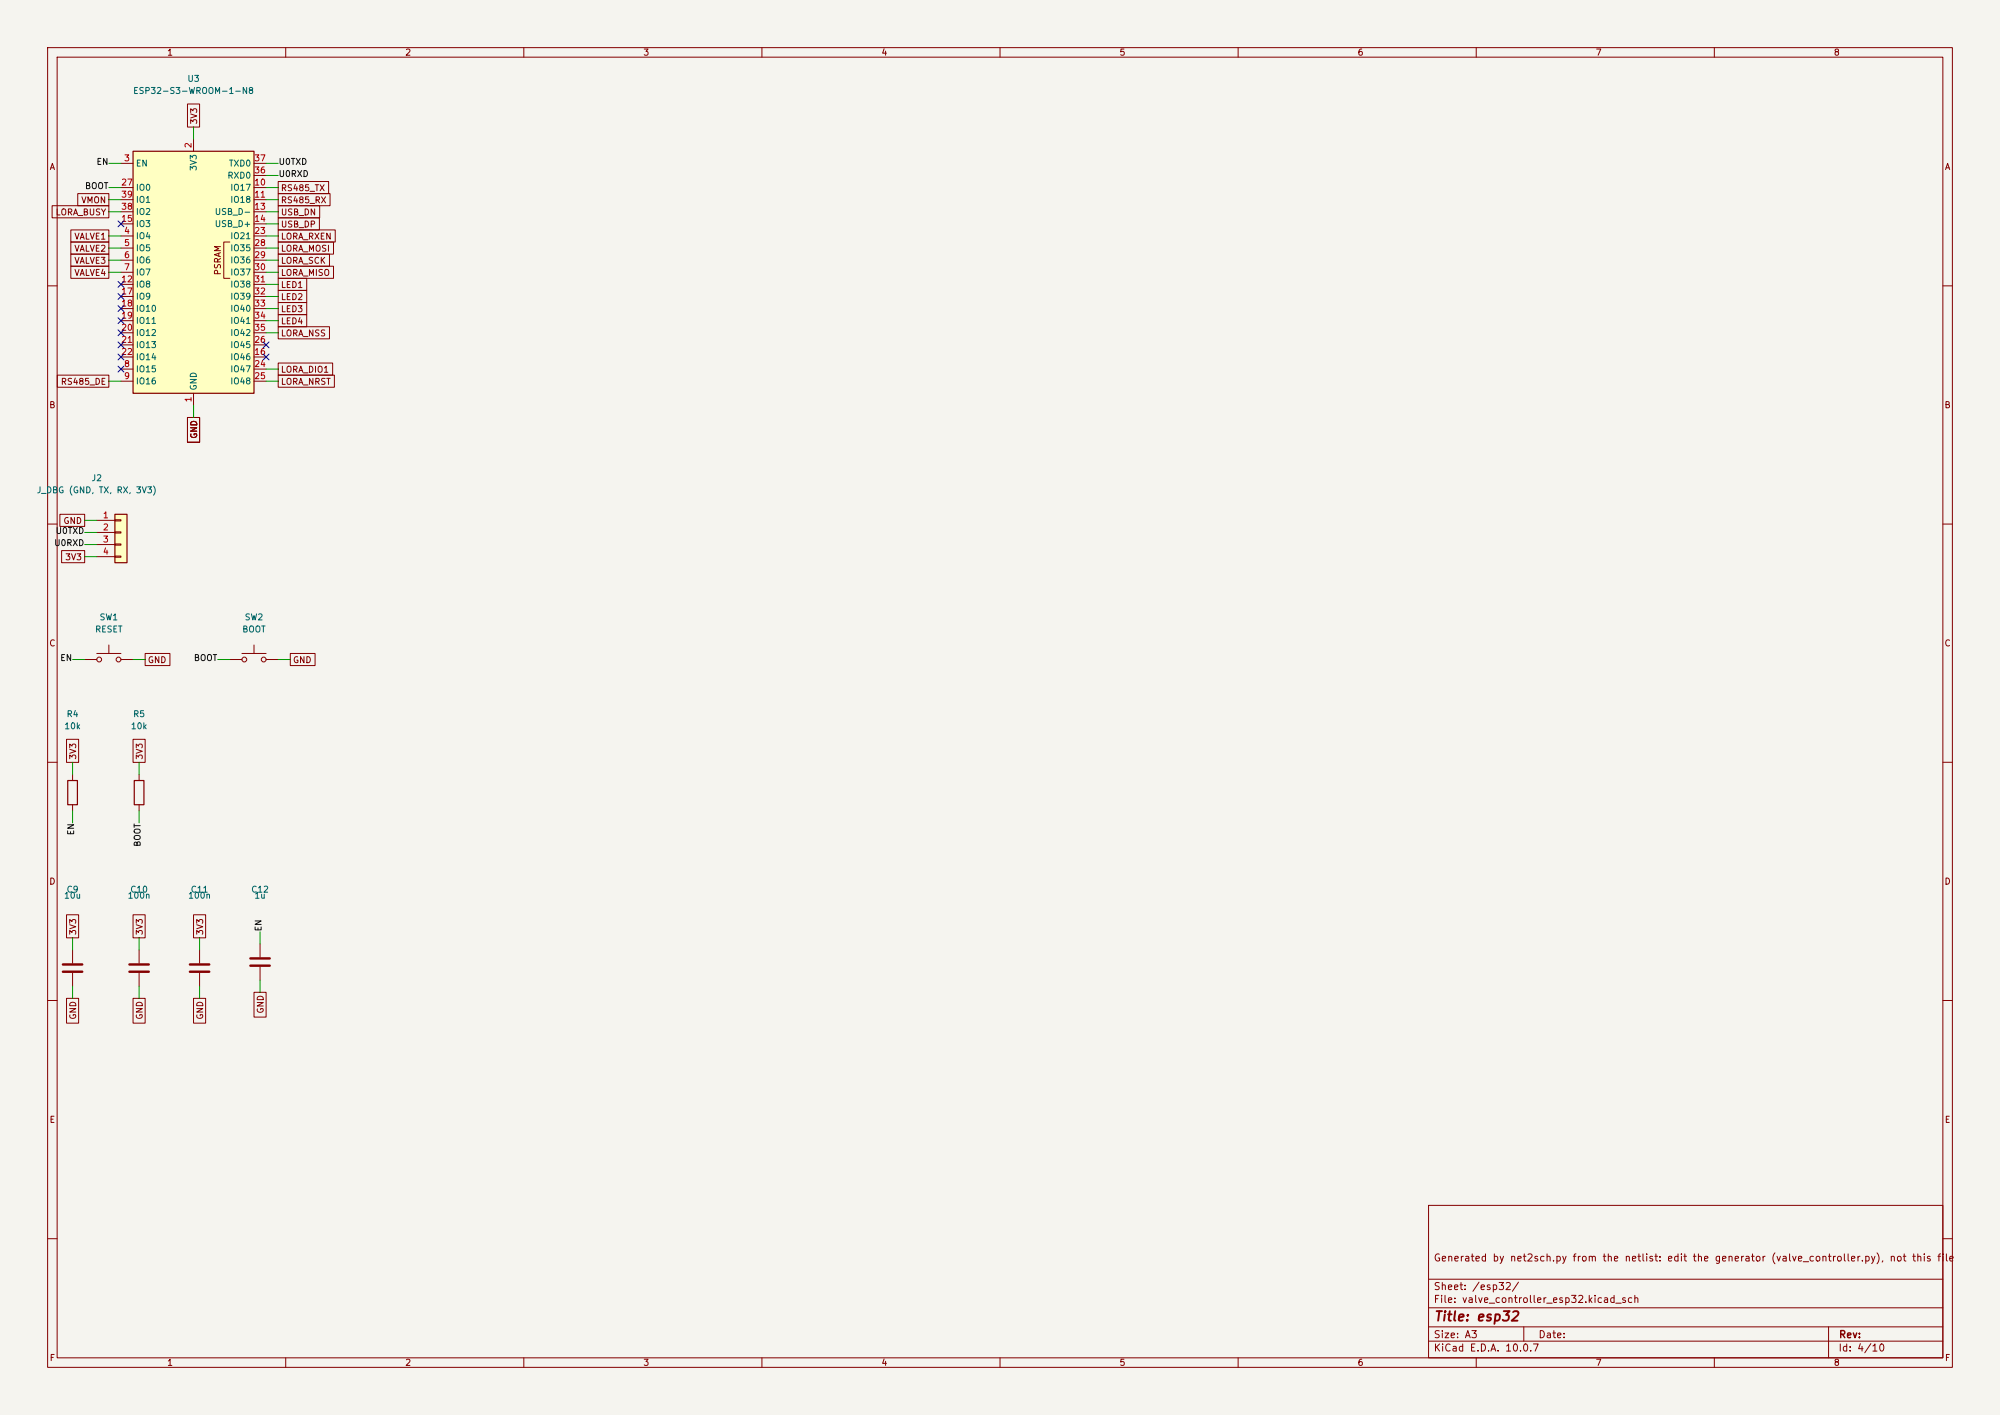
[picture p23: page 4]

Generated by net2sch.py from the netlist: edit the generator (valve_controller.py), not this file

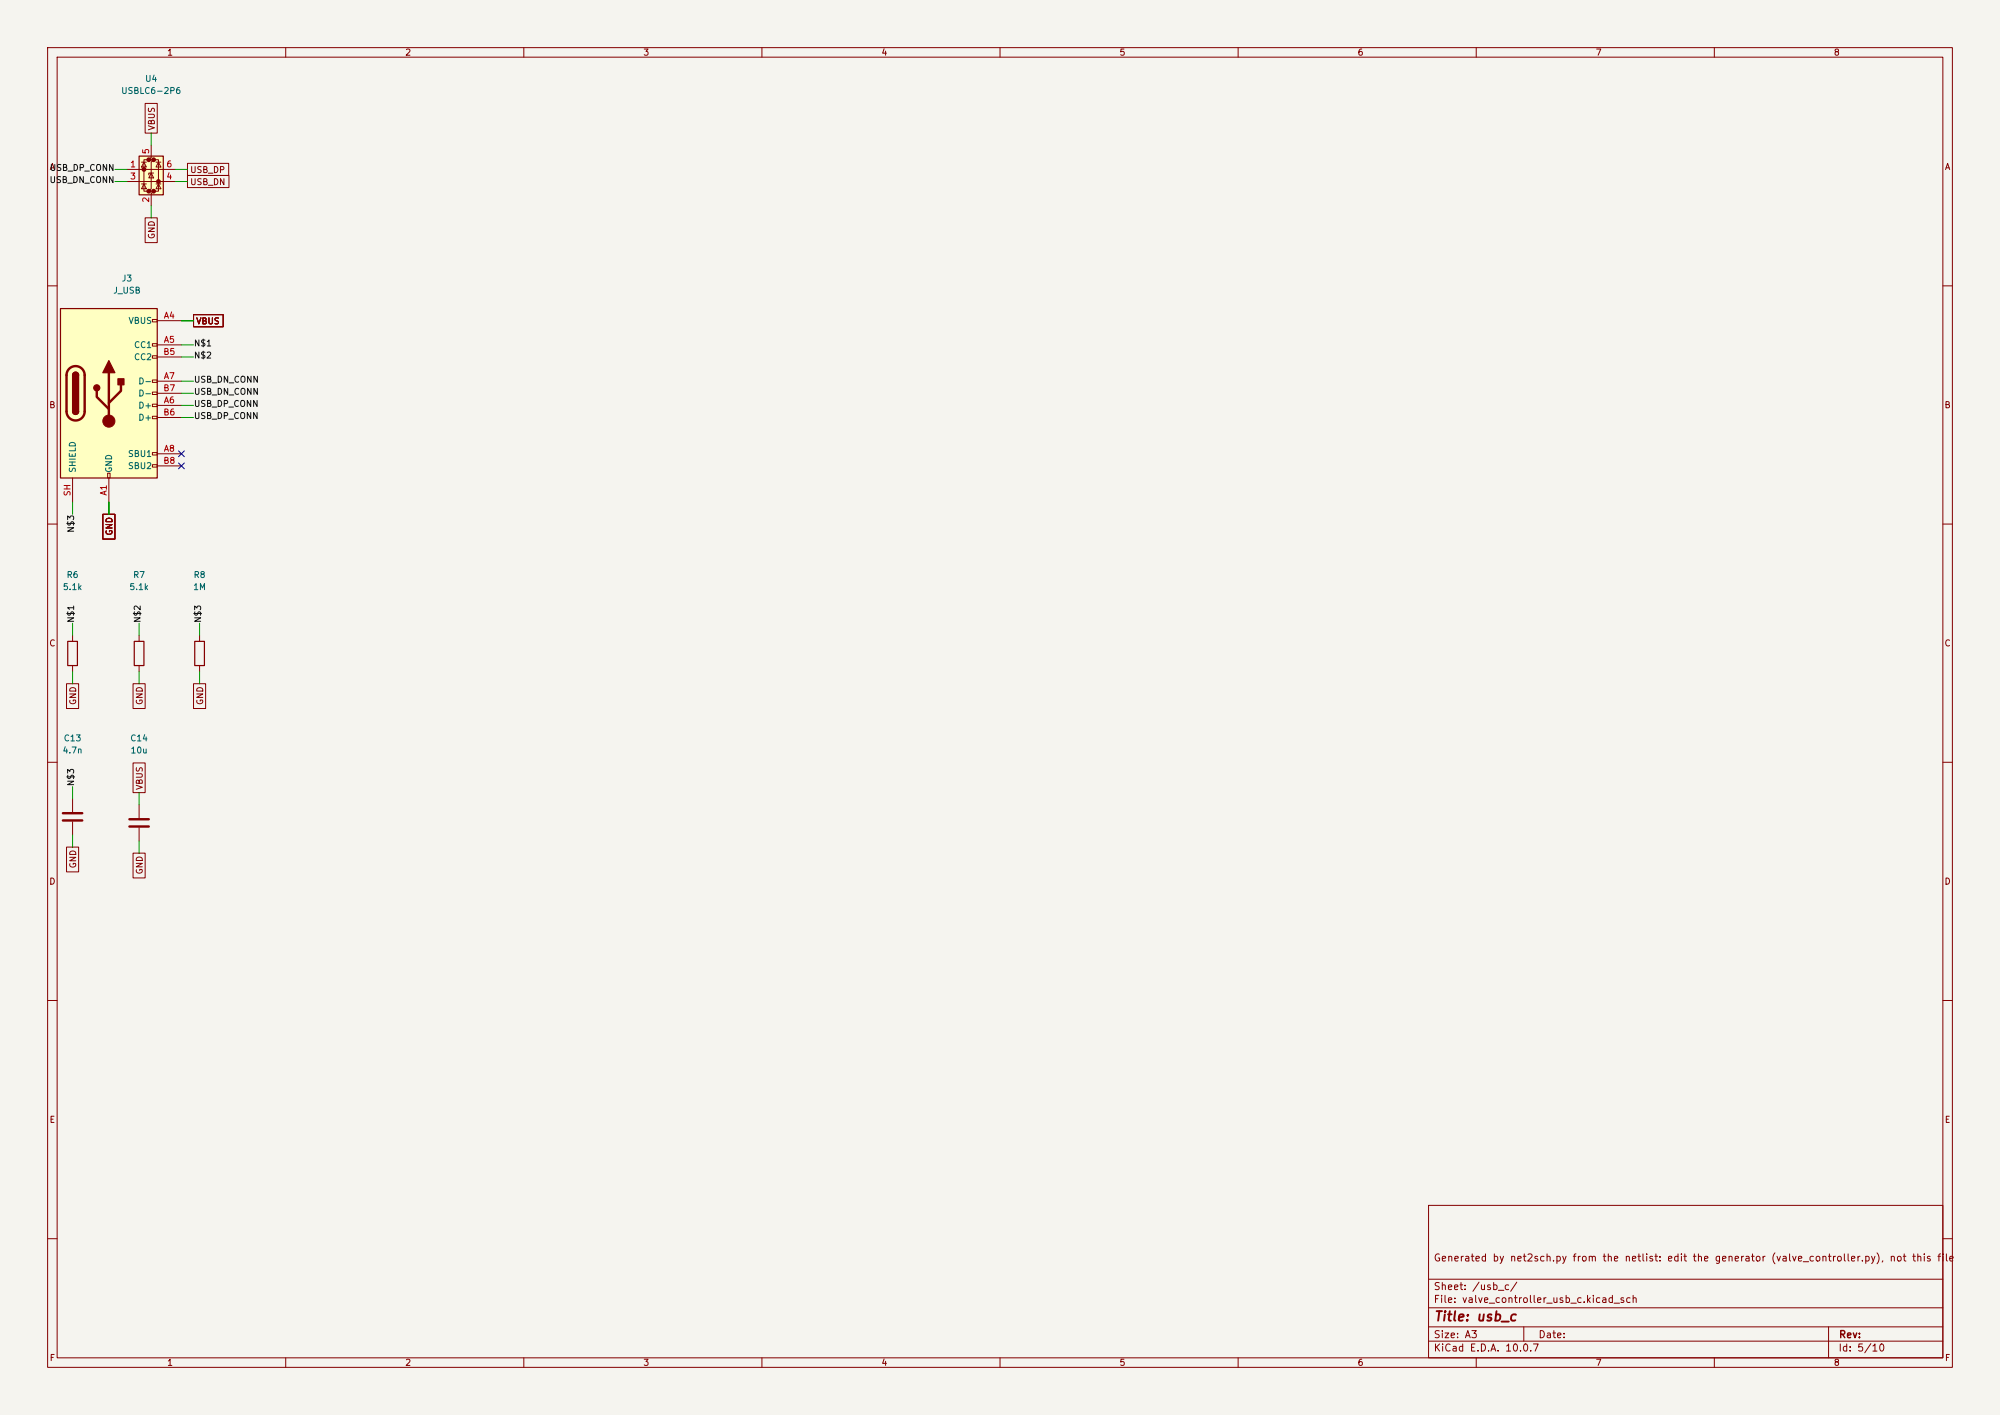
[picture p24: page 5]

Generated by net2sch.py from the netlist: edit the generator (valve_controller.py), not this file

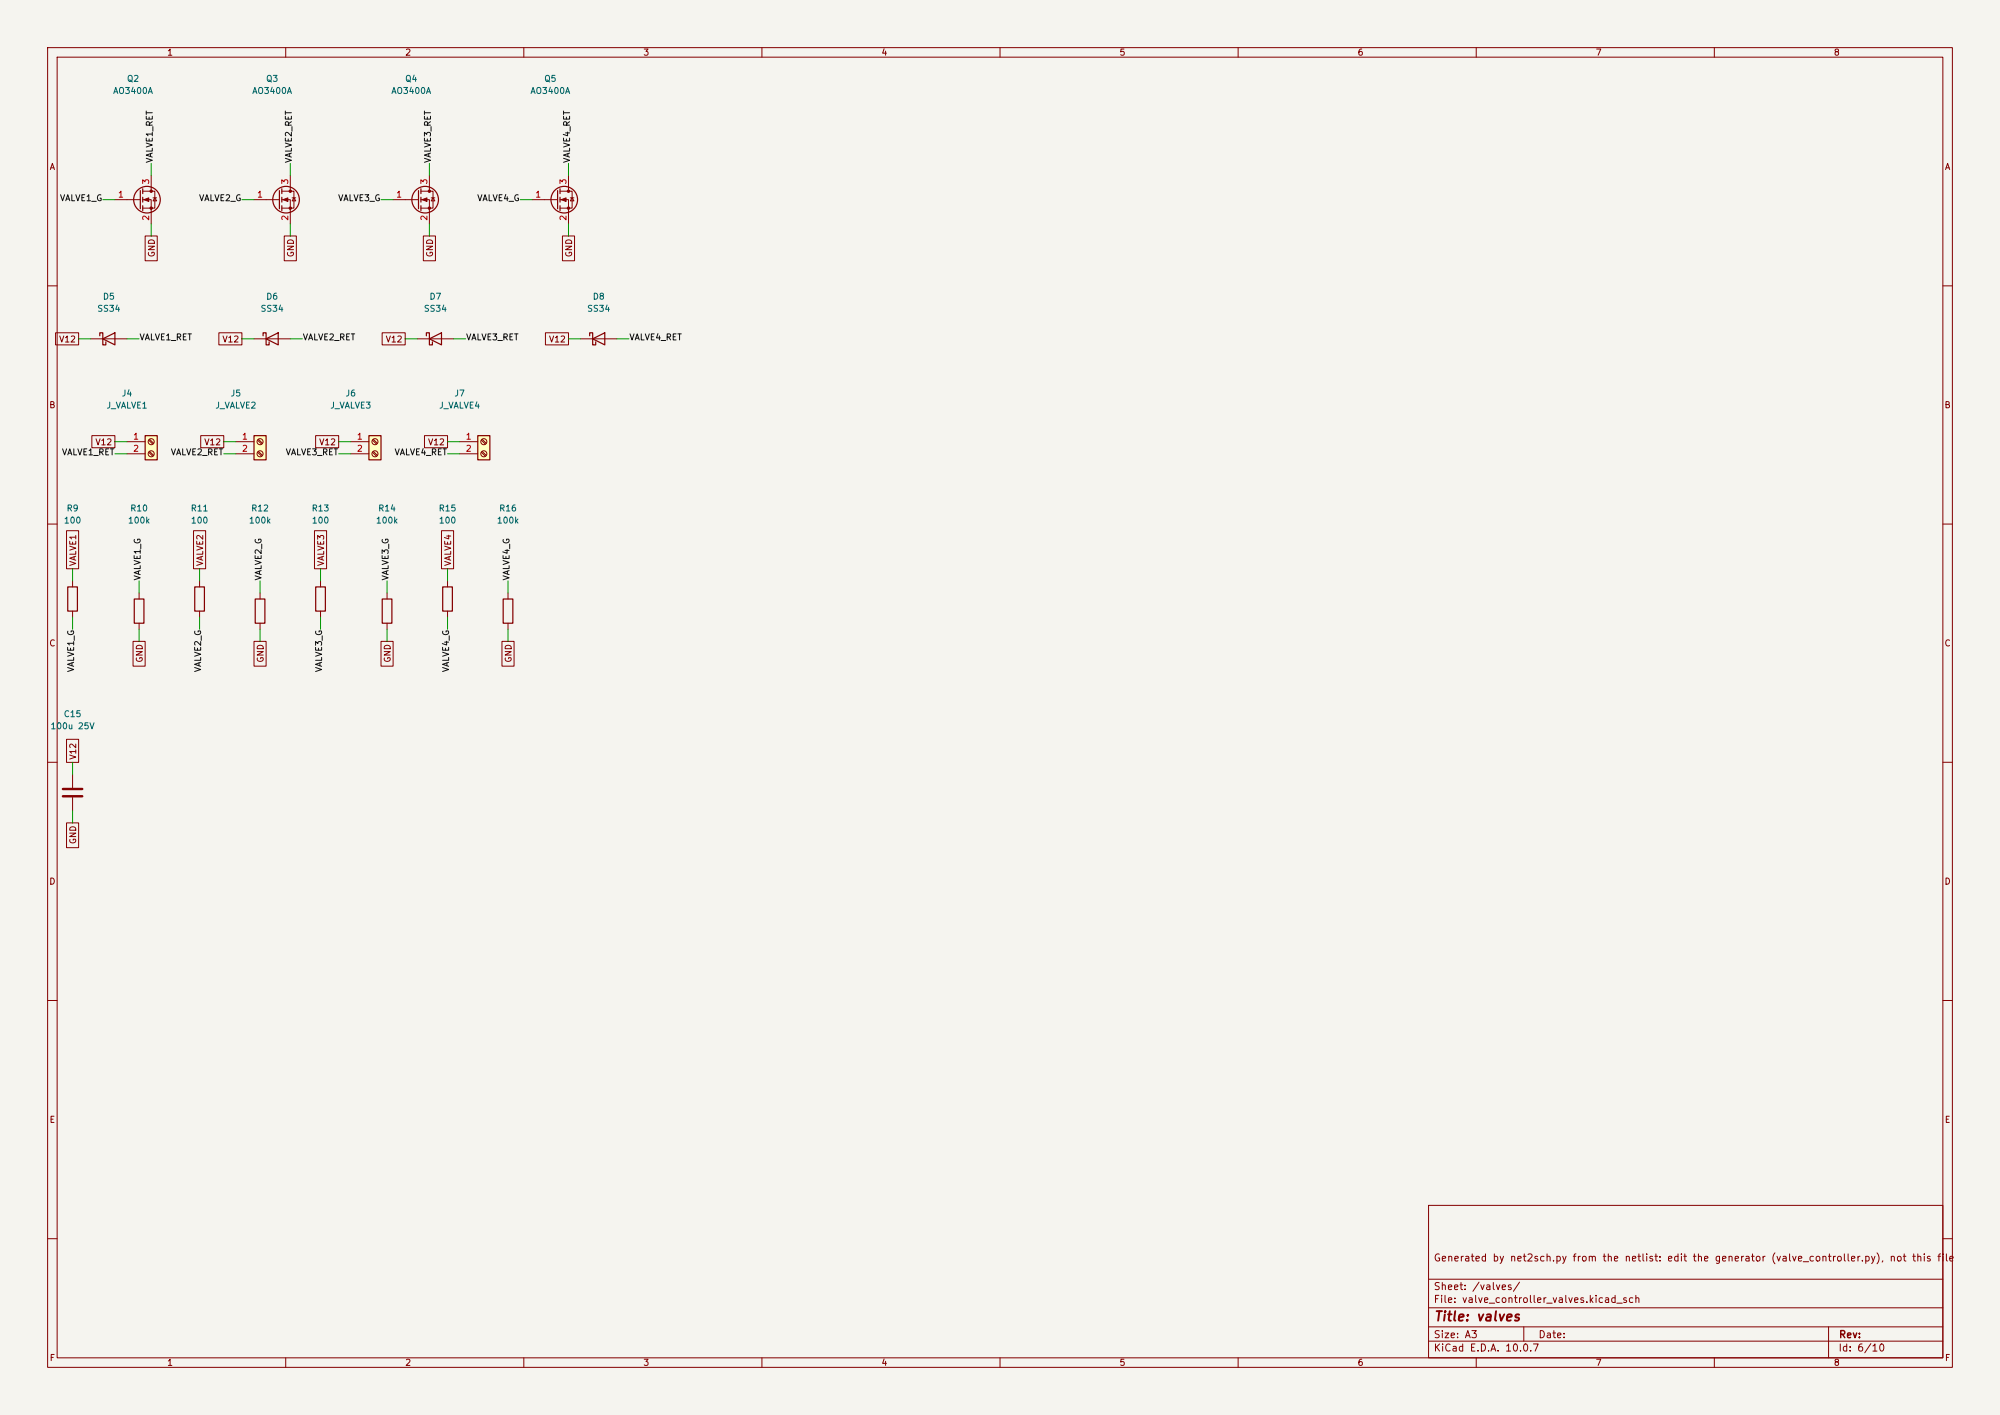
[picture p25: page 6]

Generated by net2sch.py from the netlist: edit the generator (valve_controller.py), not this file

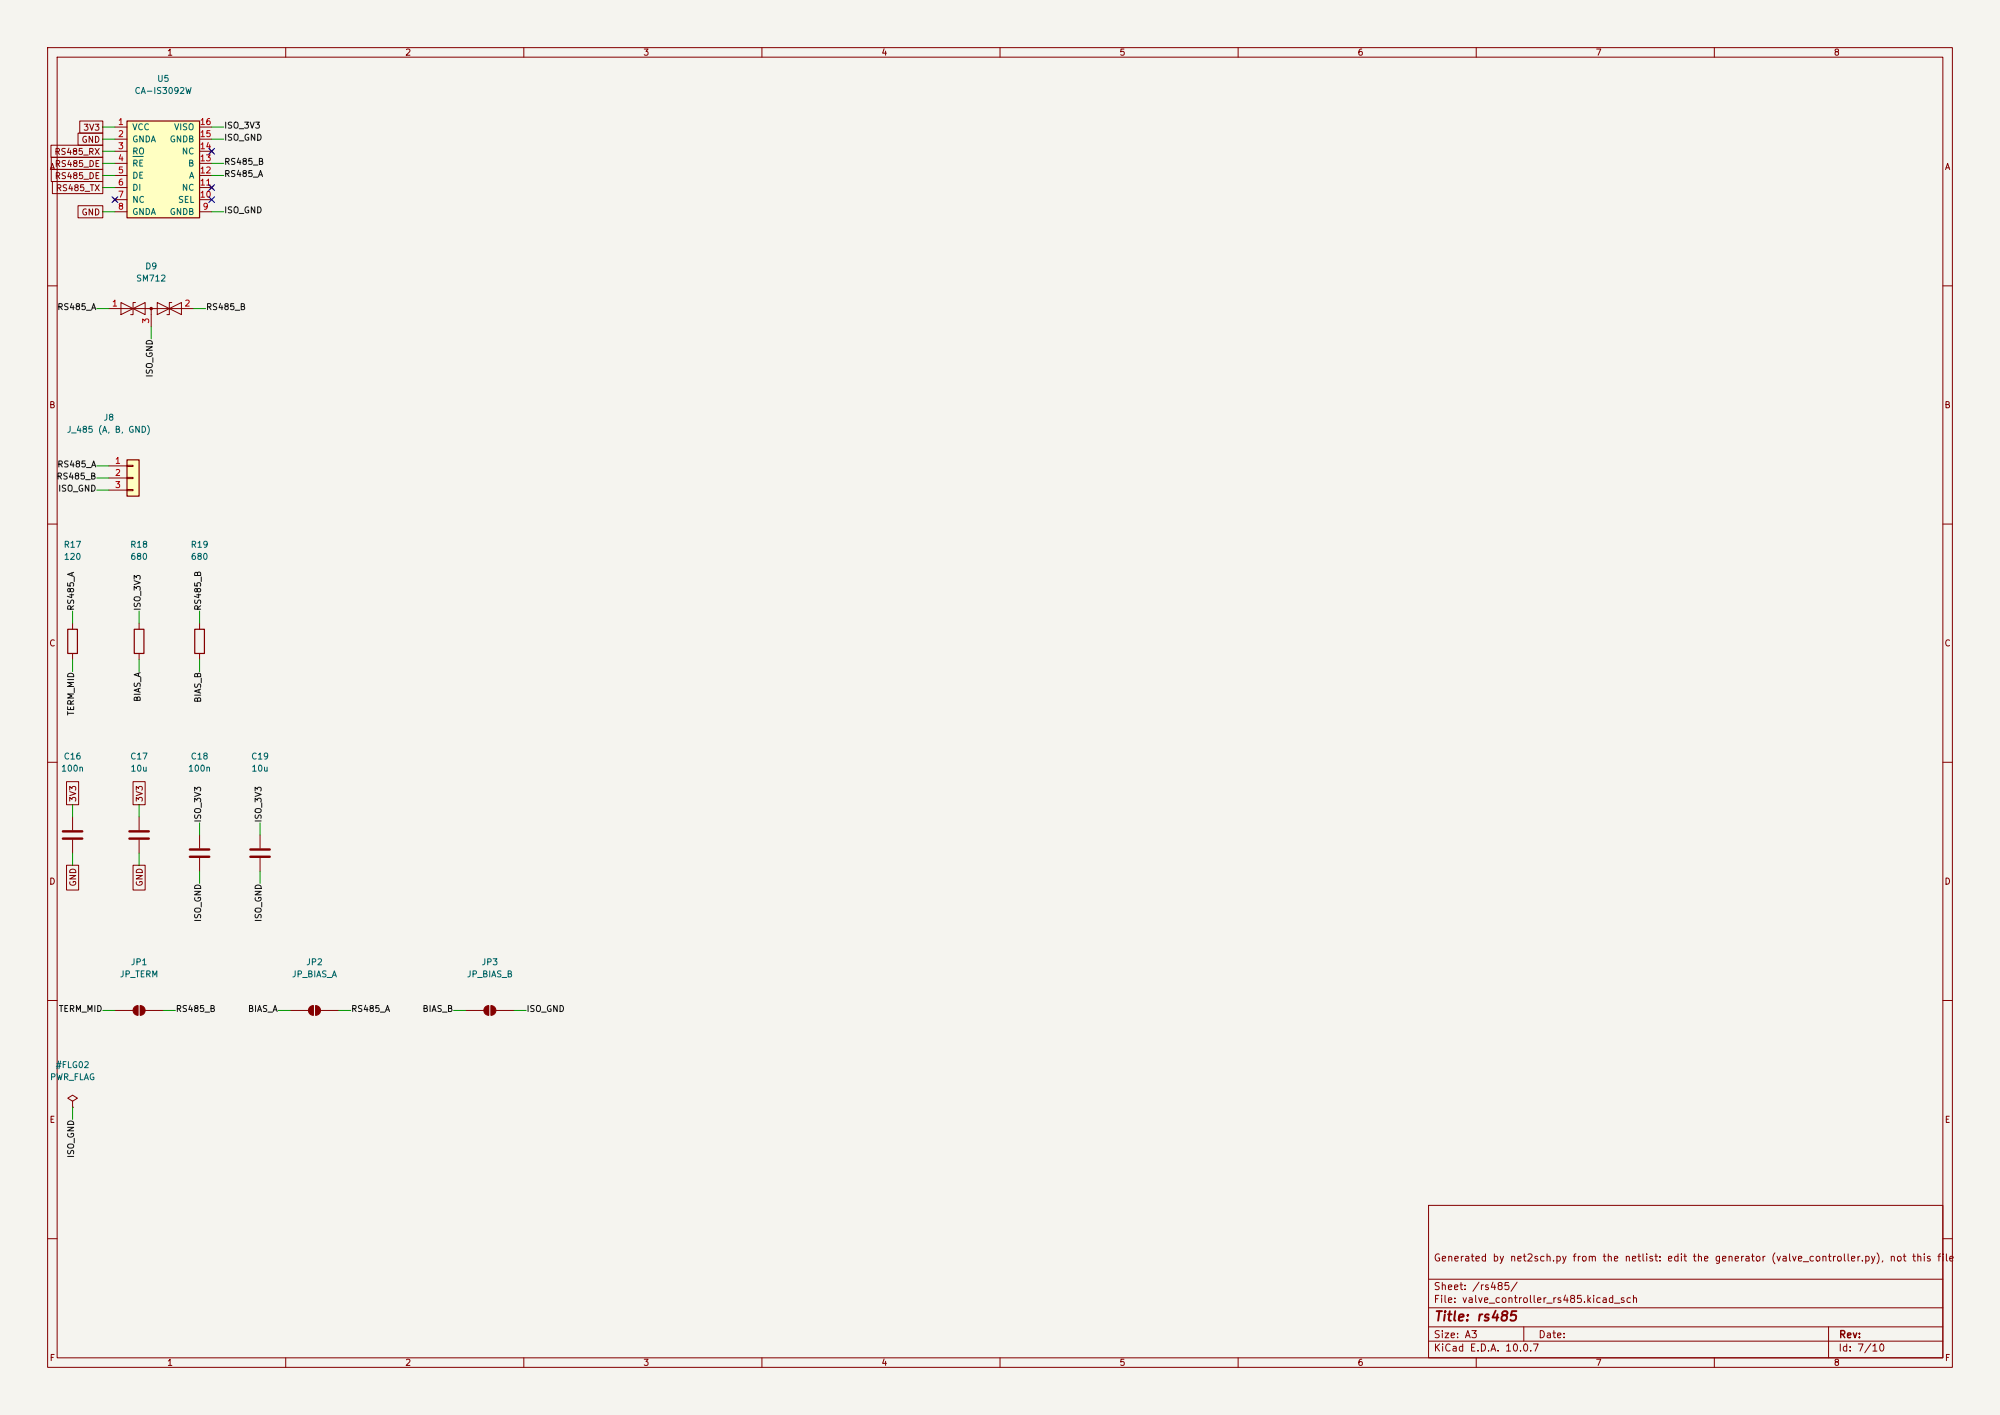
[picture p26: page 7]

Generated by net2sch.py from the netlist: edit the generator (valve_controller.py), not this file

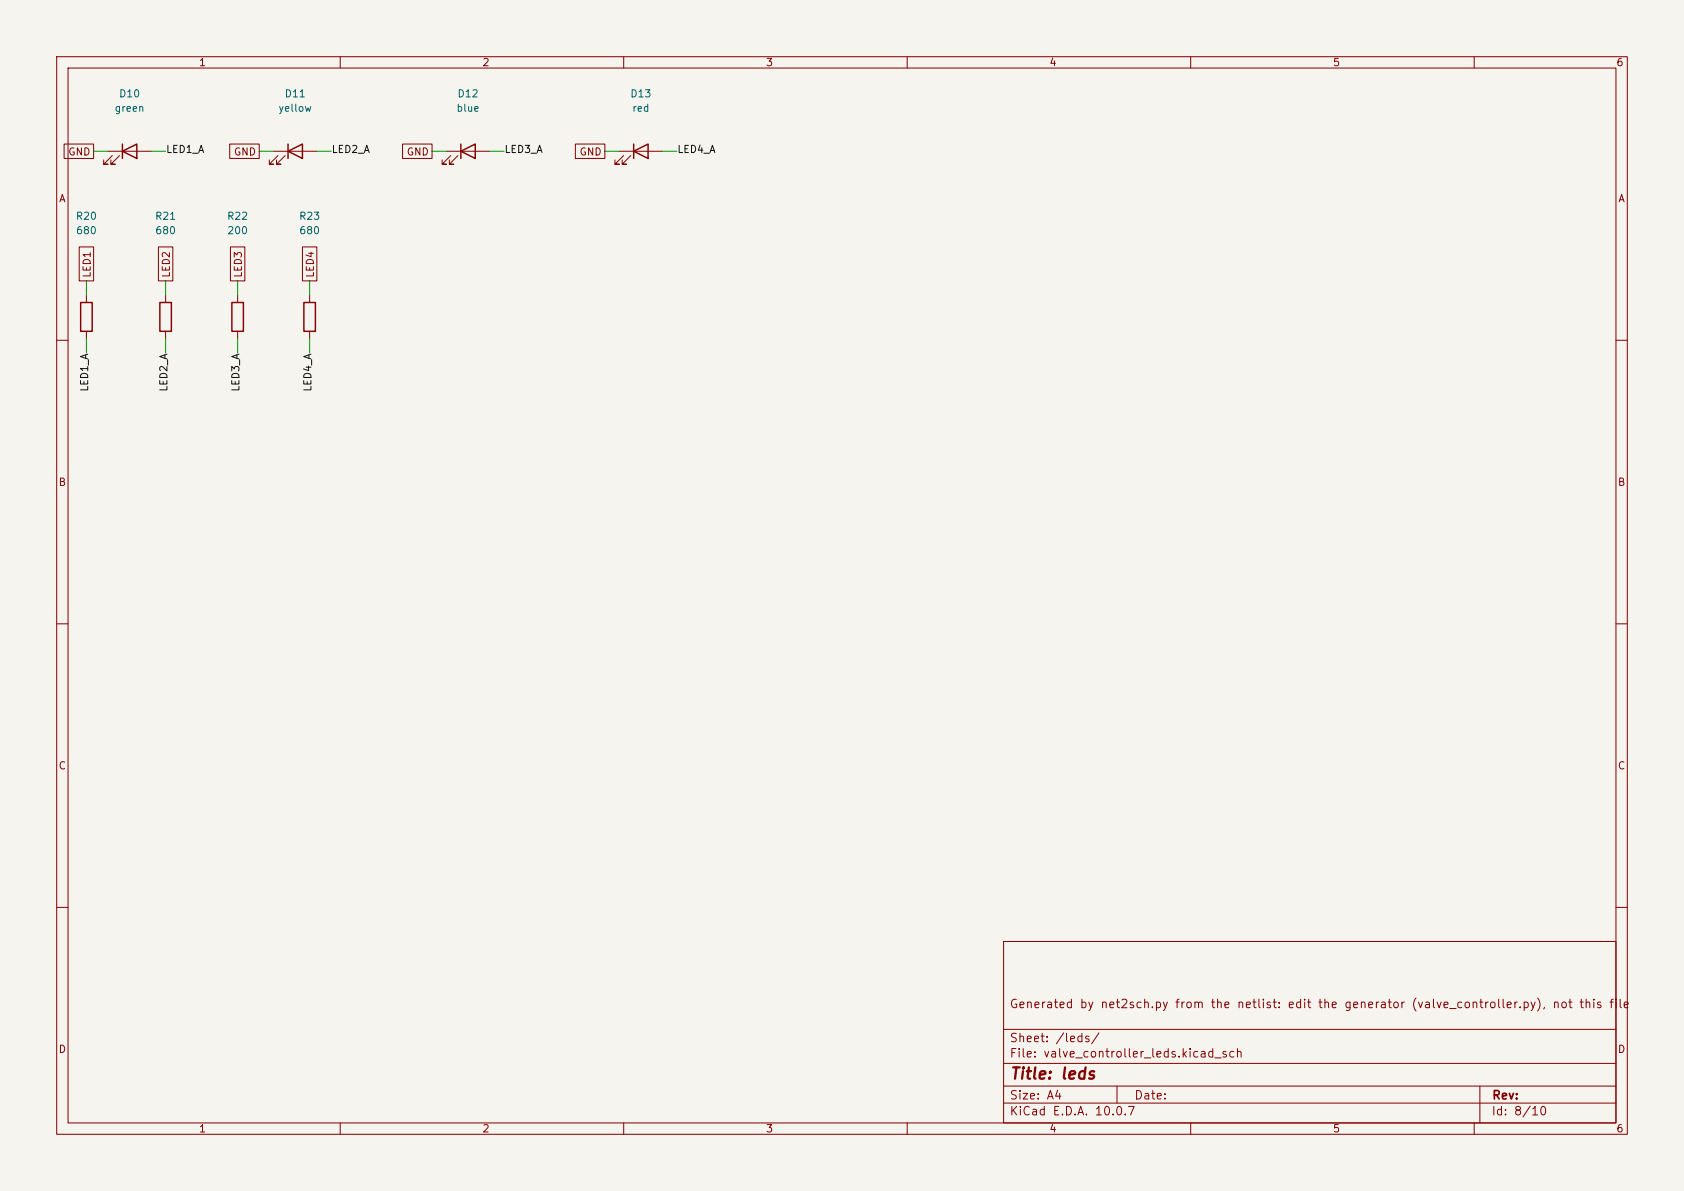
[picture p27: page 8]

Generated by net2sch.py from the netlist: edit the generator (valve_controller.py), not this file

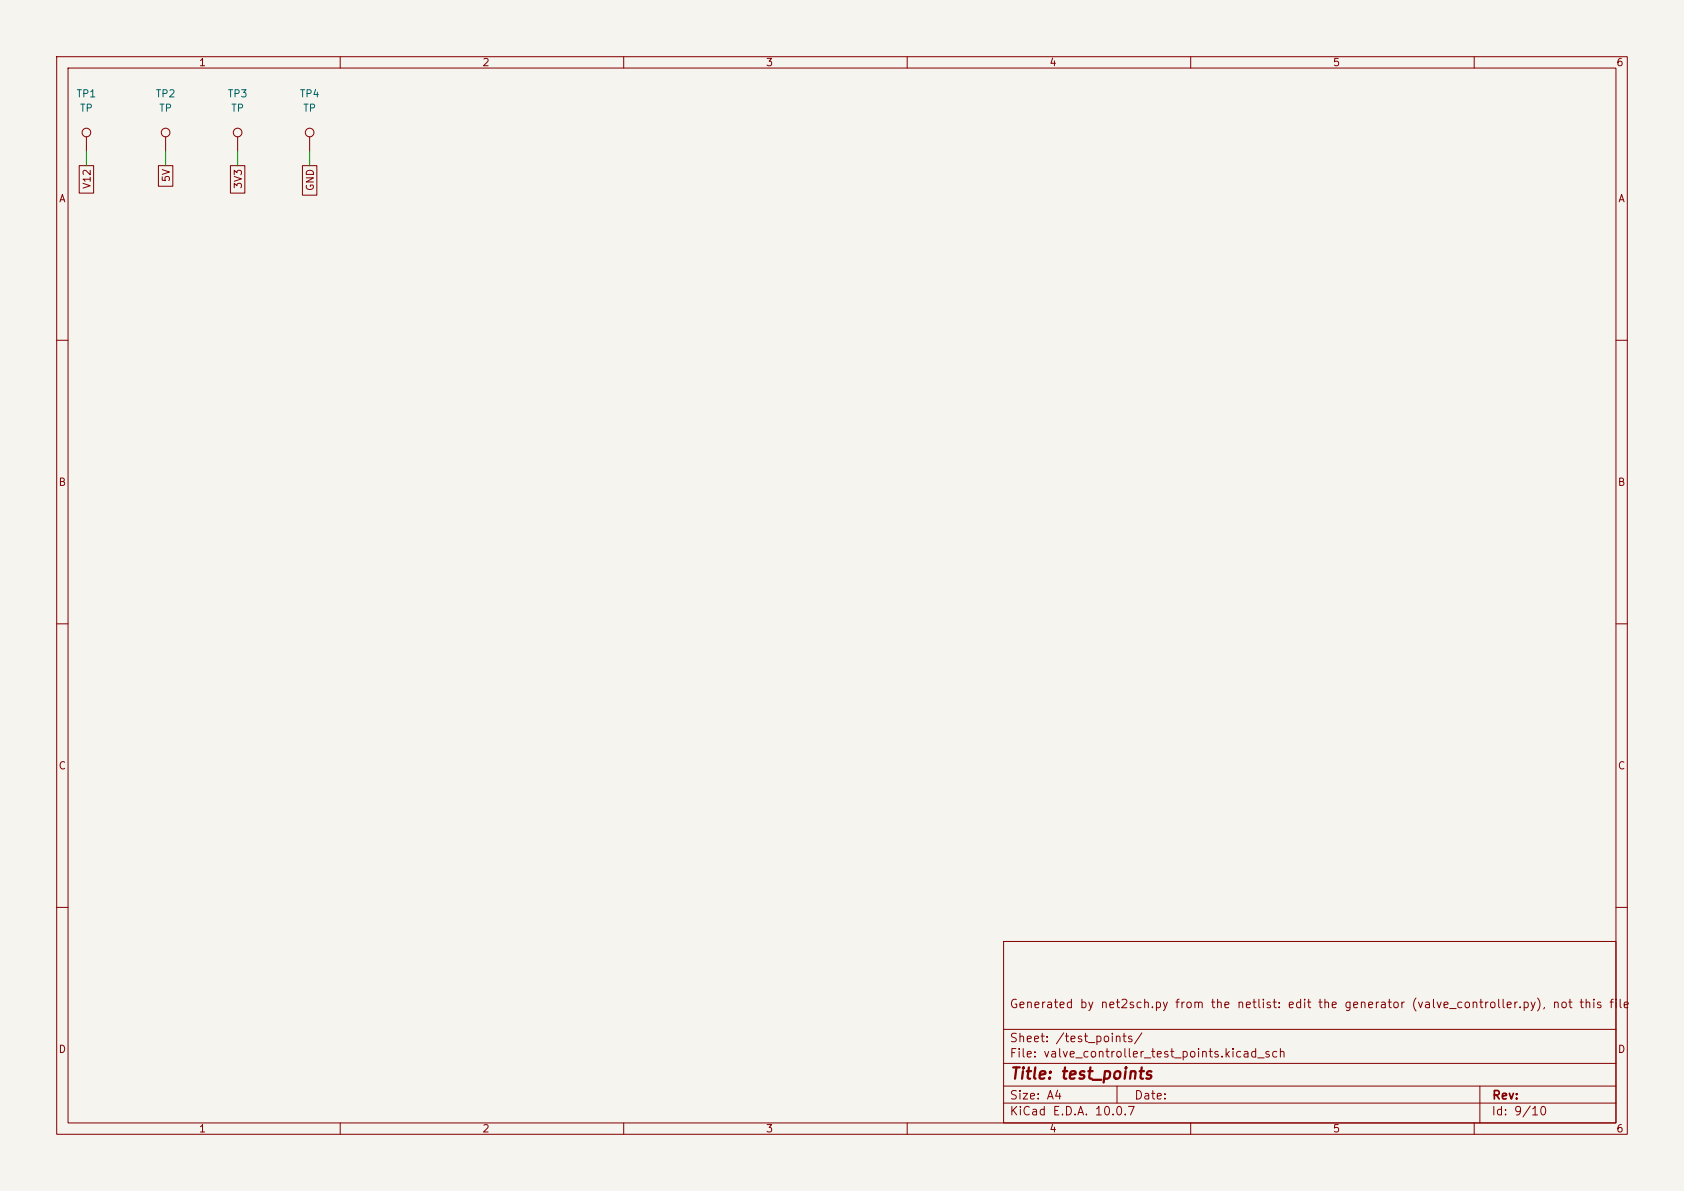
[picture p28: page 9]

Generated by net2sch.py from the netlist: edit the generator (valve_controller.py), not this file

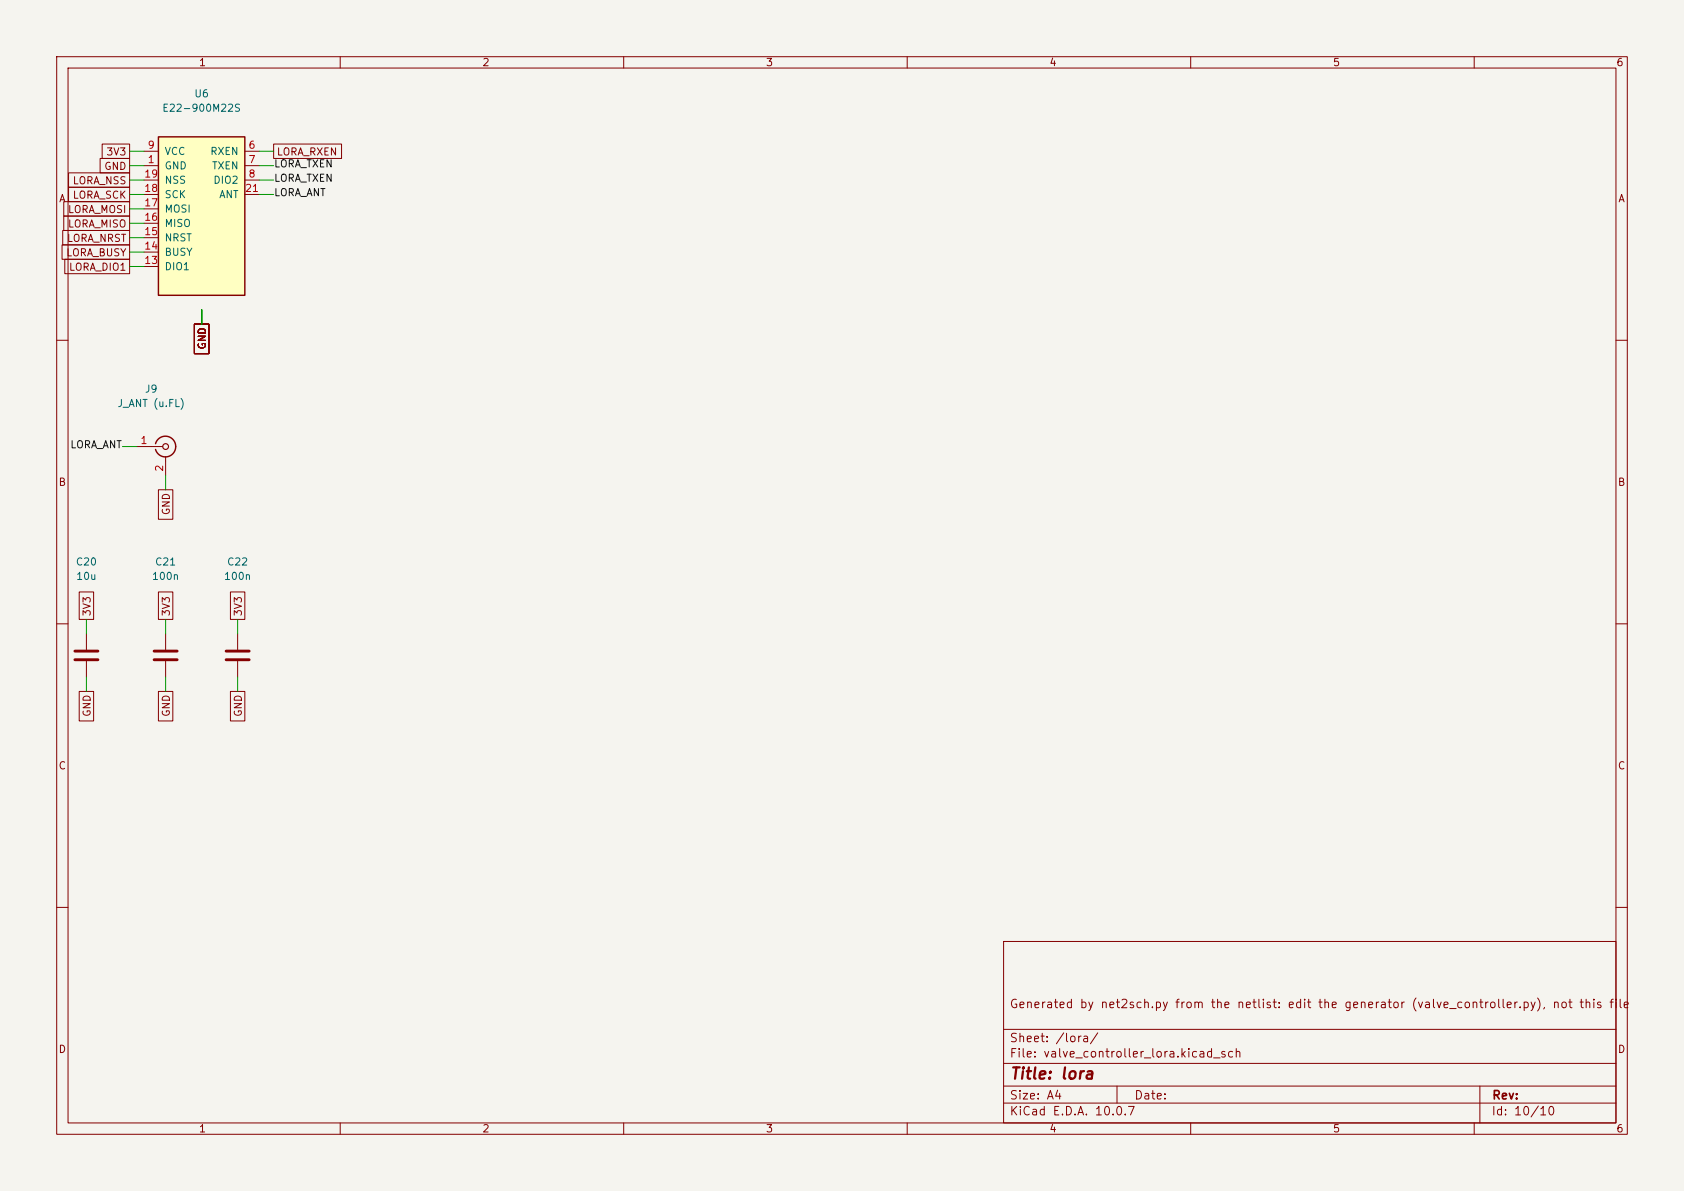
[picture p29: page 10]

Generated by net2sch.py from the netlist: edit the generator (valve_controller.py), not this file
