mtilocca/sprinkler-valve-controller/hardware/fab/assembly_top.pdf

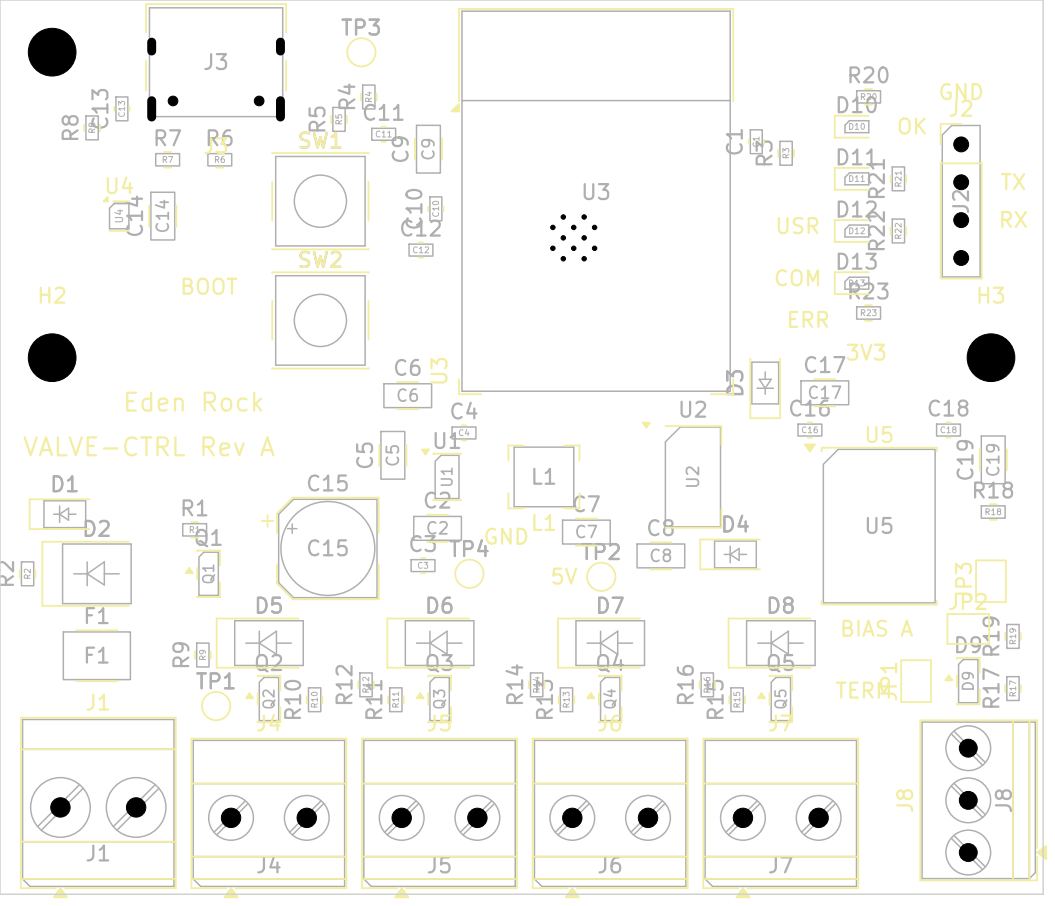
[picture p30: page 1]

TXRX VALVE-CTRL Rev A Eden Rock
