mtilocca/sprinkler-valve-controller/hardware/fab/assembly_bottom_labels.pdf

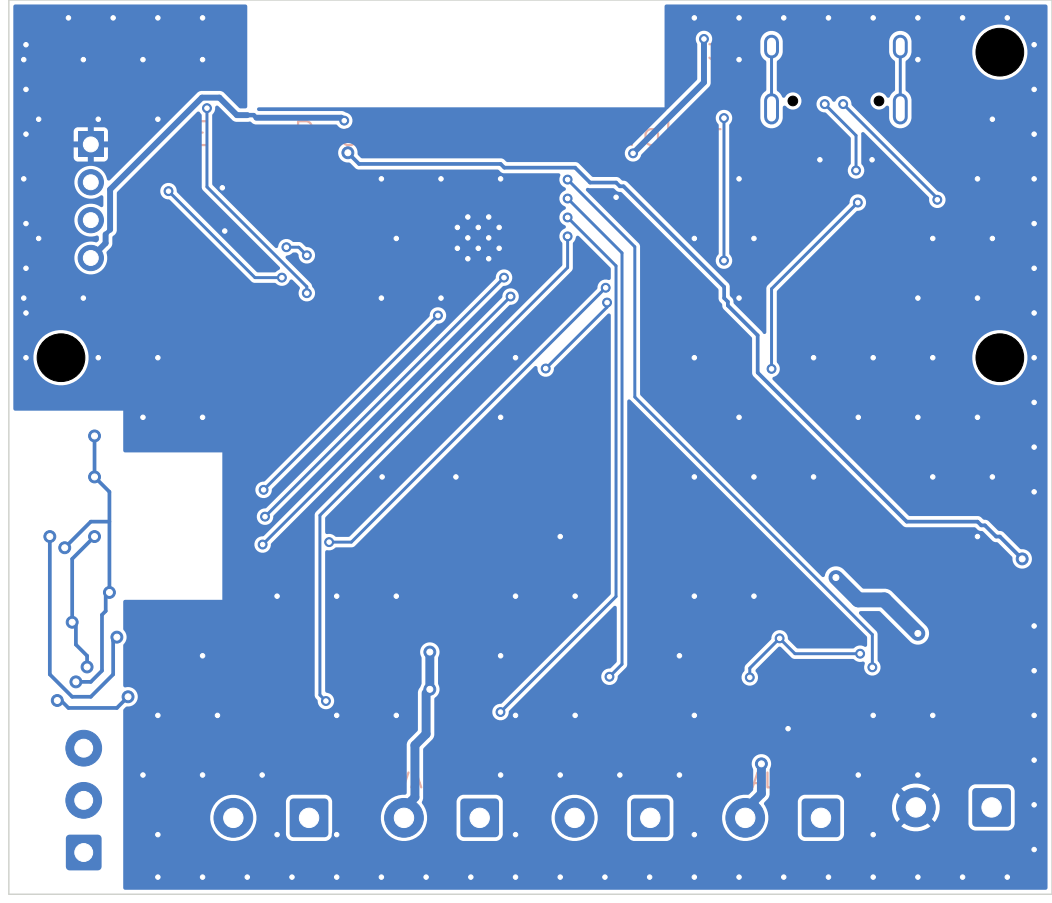
[picture p31: page 1]

A + Eden Rock Custom Controller
