mtilocca/sprinkler-valve-controller/hardware/valve_controller.kicad_pcb

## KiCad design hardware/valve_controller.kicad_pcb (2026-11-11)

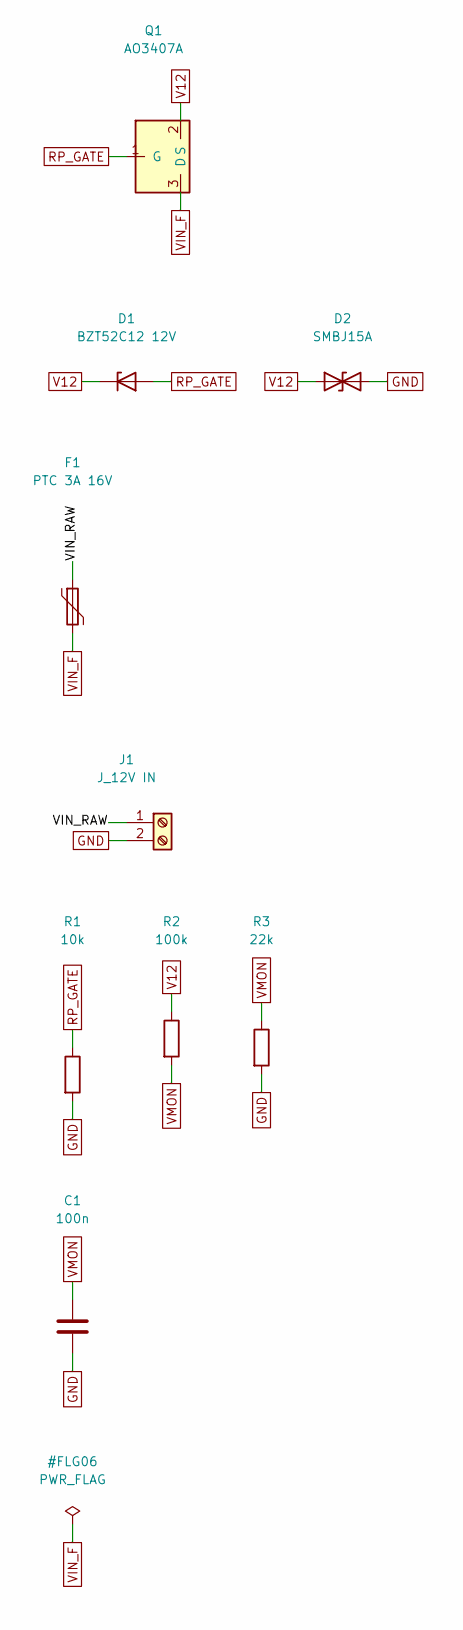
[picture p32: schematic valve_controller_power_in.kicad_sch, power_in]

Parts:
C1: 100n; C_0603_1608Metric
D1: BZT52C12 12V; D_SOD-123
D2: SMBJ15A; D_SMB
F1: PTC 3A 16V; Fuse_1812_4532Metric
J1: J_12V IN; TerminalBlock_Phoenix_MKDS-3-2-5.08_1x02_P5.08mm_Horizontal
Q1: AO3407A; SOT-23
R1: 10k; R_0603_1608Metric
R2: 100k; R_0603_1608Metric
R3: 22k; R_0603_1608Metric

Connections:
/power_in/VIN_RAW: F1.1, J1.1
GND: C1.2, D2.2 (A2), J1.2, R1.2, R3.2; also elsewhere on the board
RP_GATE: D1.2 (A), Q1.1 (G), R1.1; also elsewhere on the board
V12: D1.1 (K), D2.1 (A1), Q1.2 (S), R2.1; also elsewhere on the board
VIN_F: F1.2, Q1.3 (D); also elsewhere on the board
VMON: C1.1, R2.2, R3.1; also elsewhere on the board

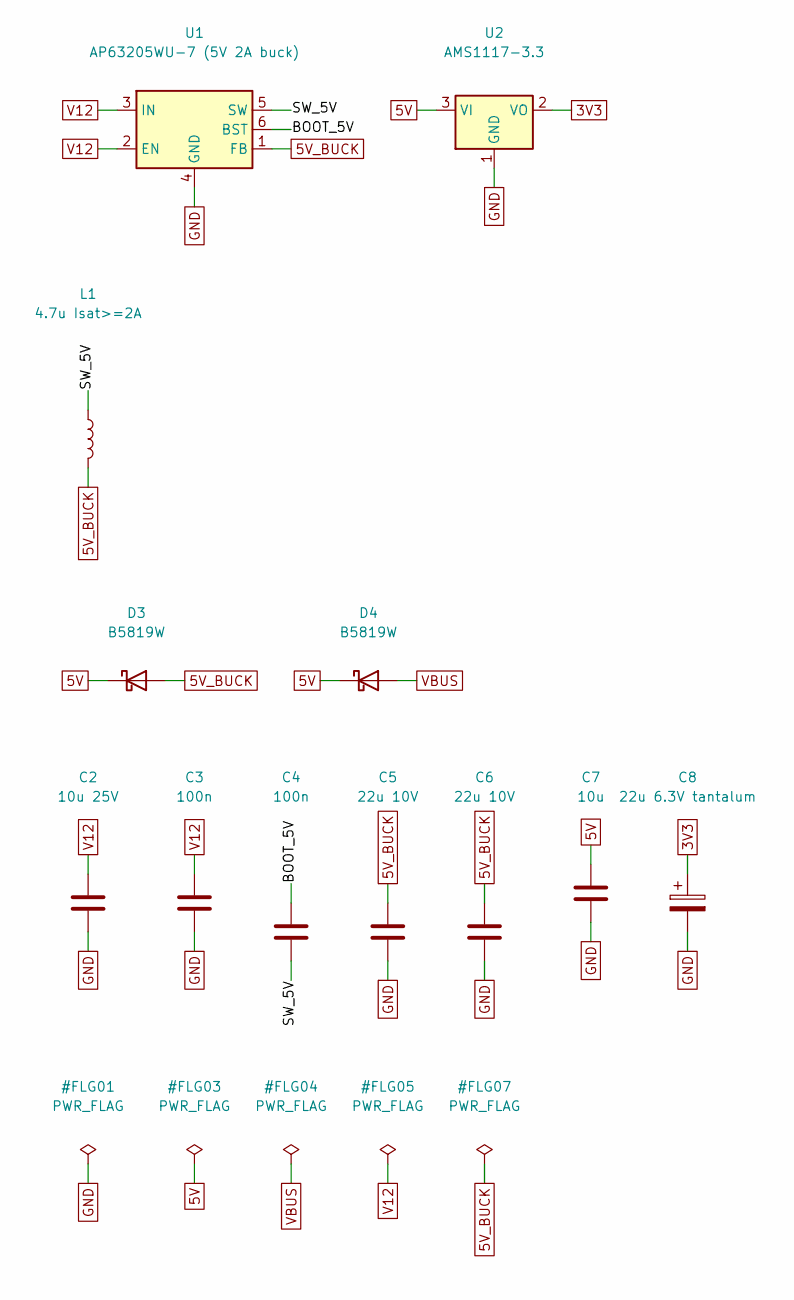
[picture p33: schematic valve_controller_aux_power.kicad_sch, aux_power]

Parts:
C2: 10u 25V; C_1206_3216Metric
C3, C4: 100n; C_0603_1608Metric
C5, C6: 22u 10V; C_1206_3216Metric
C7: 10u; C_1206_3216Metric
C8: 22u 6.3V tantalum; CP_EIA-3216-18_Kemet-A
D3, D4: B5819W; D_SOD-123
L1: 4.7u Isat>=2A; L_Bourns-SRN4018
U1: AP63205WU-7 (5V 2A buck); TSOT-23-6
U2: AMS1117-3.3; SOT-223-3_TabPin2

Connections:
3V3: C8.1, U2.2 (VO); also elsewhere on the board
5V: C7.1, D3.1 (K), D4.1 (K), U2.3 (VI); also elsewhere on the board
5V_BUCK: C5.1, C6.1, D3.2 (A), L1.2, U1.1 (FB); also elsewhere on the board
/aux_power/BOOT_5V: C4.1, U1.6 (BST)
/aux_power/SW_5V: C4.2, L1.1, U1.5 (SW)
GND: C2.2, C3.2, C5.2, C6.2, C7.2, C8.2, U1.4 (GND), U2.1 (GND); also elsewhere on the board
V12: C2.1, C3.1, U1.2 (EN), U1.3 (IN); also elsewhere on the board
VBUS: D4.2 (A); also elsewhere on the board

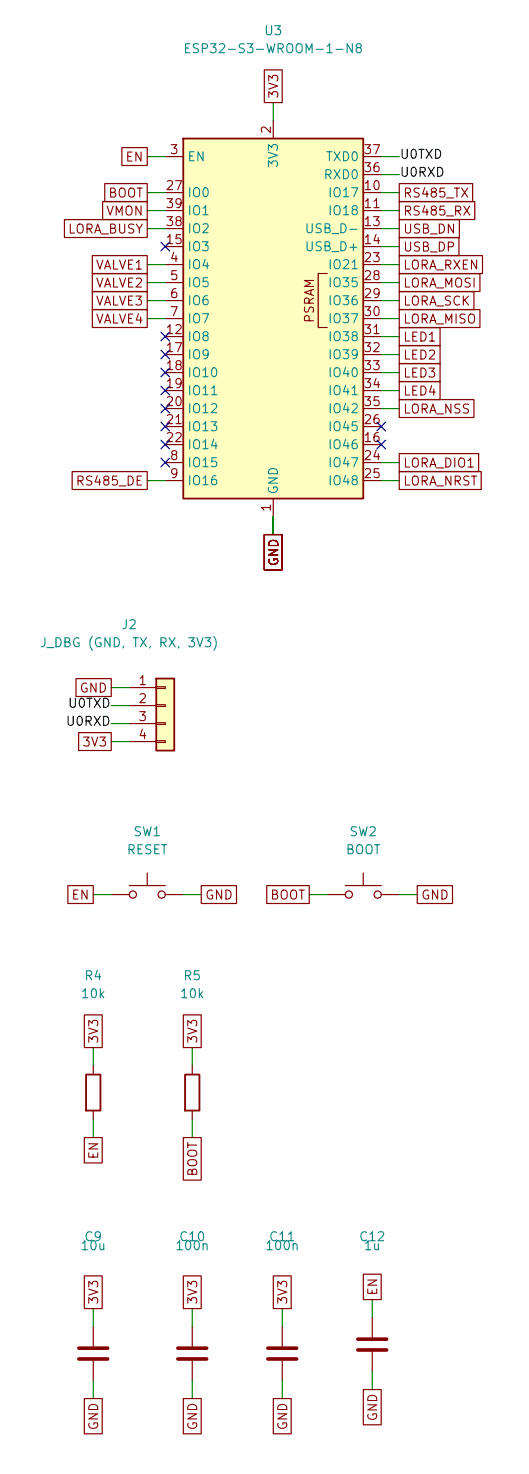
[picture p34: schematic valve_controller_esp32.kicad_sch, esp32]

Parts:
C9: 10u; C_1206_3216Metric
C10, C11: 100n; C_0603_1608Metric
C12: 1u; C_0603_1608Metric
J2: J_DBG (GND, TX, RX, 3V3); PinHeader_1x04_P2.54mm_Vertical
R4, R5: 10k; R_0603_1608Metric
SW1: RESET; SW_SPST_PTS645Sx43SMTR92
SW2: BOOT; SW_SPST_PTS645Sx43SMTR92
U3: ESP32-S3-WROOM-1-N8; ESP32-S3-WROOM-1

Connections:
3V3: C9.1, C10.1, C11.1, J2.4, R4.1, R5.1, U3.2 (3V3); also elsewhere on the board
/esp32/U0RXD: J2.3, U3.36 (RXD0)
/esp32/U0TXD: J2.2, U3.37 (TXD0)
BOOT: R5.2, SW2.1, U3.27 (IO0); also elsewhere on the board
EN: C12.1, R4.2, SW1.1, U3.3 (EN); also elsewhere on the board
GND: C9.2, C10.2, C11.2, C12.2, J2.1, SW1.2, SW2.2, U3.1 (GND), U3.40 (GND), U3.41 (GND); also elsewhere on the board
LED1: U3.31 (IO38); also elsewhere on the board
LED2: U3.32 (IO39); also elsewhere on the board
LED3: U3.33 (IO40); also elsewhere on the board
LED4: U3.34 (IO41); also elsewhere on the board
LORA_BUSY: U3.38 (IO2); also elsewhere on the board
LORA_DIO1: U3.24 (IO47); also elsewhere on the board
LORA_MISO: U3.30 (IO37); also elsewhere on the board
LORA_MOSI: U3.28 (IO35); also elsewhere on the board
LORA_NRST: U3.25 (IO48); also elsewhere on the board
LORA_NSS: U3.35 (IO42); also elsewhere on the board
LORA_RXEN: U3.23 (IO21); also elsewhere on the board
LORA_SCK: U3.29 (IO36); also elsewhere on the board
RS485_DE: U3.9 (IO16); also elsewhere on the board
RS485_RX: U3.11 (IO18); also elsewhere on the board
RS485_TX: U3.10 (IO17); also elsewhere on the board
USB_DN: U3.13 (USB_D-); also elsewhere on the board
USB_DP: U3.14 (USB_D+); also elsewhere on the board
VALVE1: U3.4 (IO4); also elsewhere on the board
VALVE2: U3.5 (IO5); also elsewhere on the board
VALVE3: U3.6 (IO6); also elsewhere on the board
VALVE4: U3.7 (IO7); also elsewhere on the board
VMON: U3.39 (IO1); also elsewhere on the board

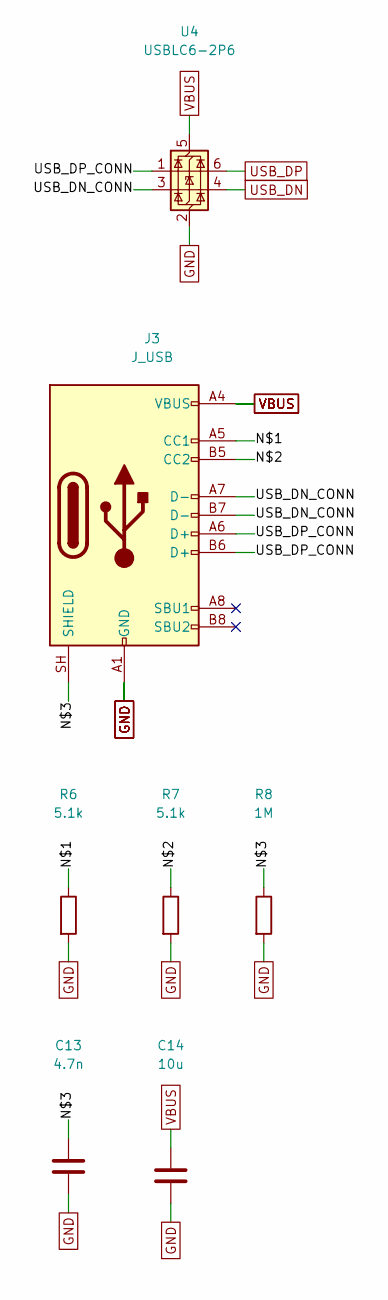
[picture p35: schematic valve_controller_usb_c.kicad_sch, usb_c]

Parts:
C13: 4.7n; C_0603_1608Metric
C14: 10u; C_1206_3216Metric
J3: J_USB; USB_C_Receptacle_HRO_TYPE-C-31-M-12
R6, R7: 5.1k; R_0603_1608Metric
R8: 1M; R_0603_1608Metric
U4: USBLC6-2P6; SOT-666

Connections:
/usb_c/N$1: J3.A5 (CC1), R6.1
/usb_c/N$2: J3.B5 (CC2), R7.1
/usb_c/N$3: C13.1, J3.SH (SHIELD), R8.1
/usb_c/USB_DN_CONN: J3.A7 (D-), J3.B7 (D-), U4.3 (I/O2)
/usb_c/USB_DP_CONN: J3.A6 (D+), J3.B6 (D+), U4.1 (I/O1)
GND: C13.2, C14.2, J3.A1 (GND), J3.A12 (GND), J3.B1 (GND), J3.B12 (GND), R6.2, R7.2, R8.2, U4.2 (GND); also elsewhere on the board
USB_DN: U4.4 (I/O2); also elsewhere on the board
USB_DP: U4.6 (I/O1); also elsewhere on the board
VBUS: C14.1, J3.A4 (VBUS), J3.A9 (VBUS), J3.B4 (VBUS), J3.B9 (VBUS), U4.5 (VBUS); also elsewhere on the board

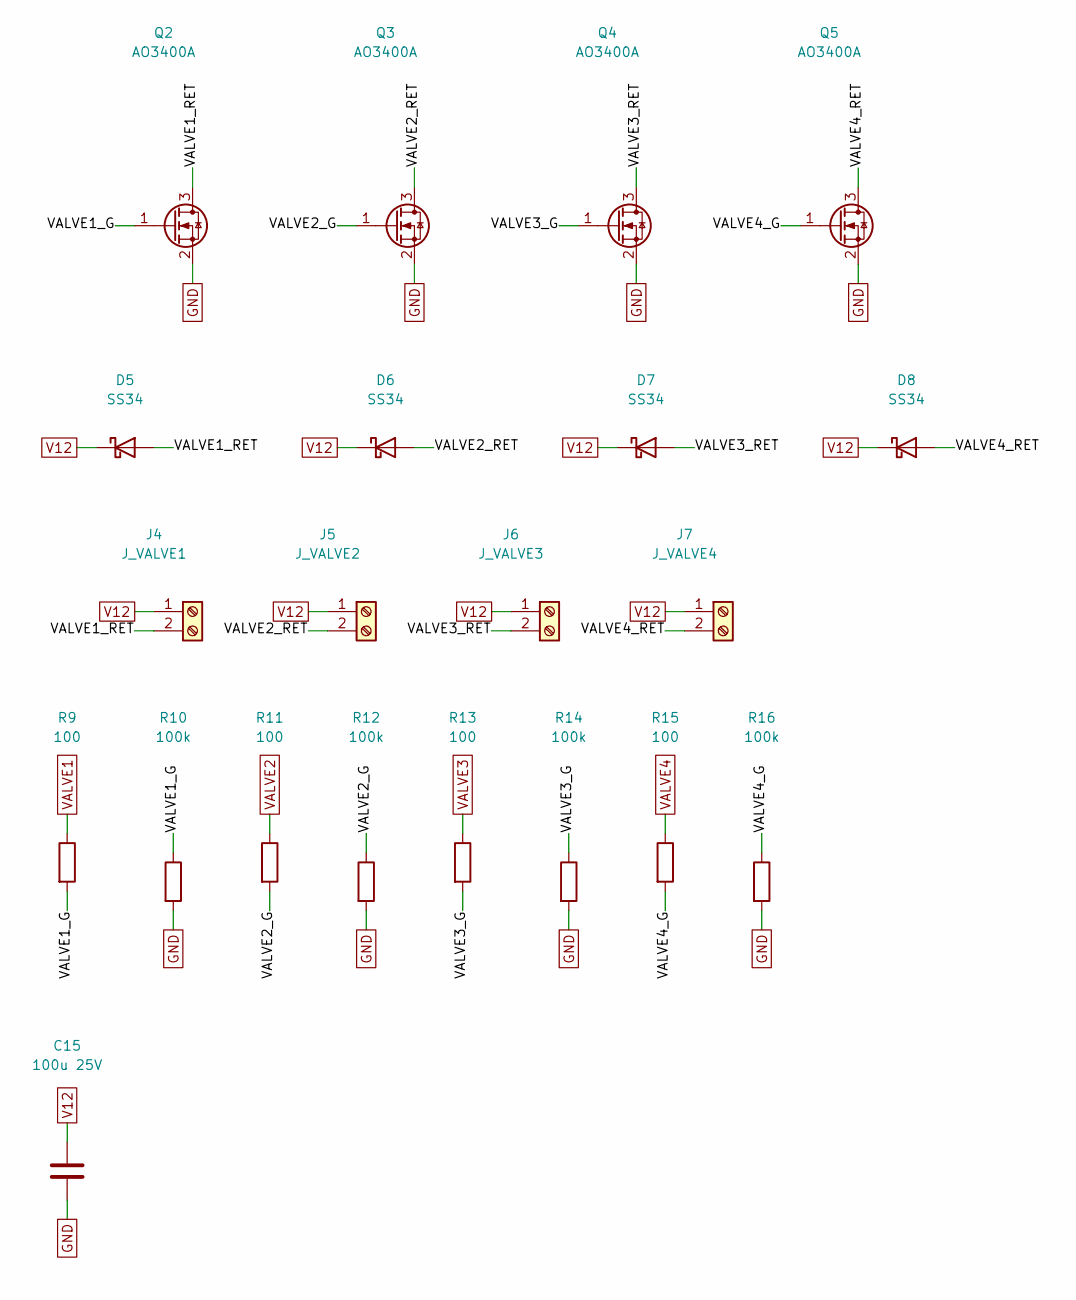
[picture p36: schematic valve_controller_valves.kicad_sch, valves]

Parts:
C15: 100u 25V; CP_Elec_6.3x7.7
D5, D6, D7, D8: SS34; D_SMA
J4: J_VALVE1; TerminalBlock_Phoenix_MKDS-1,5-2-5.08_1x02_P5.08mm_Horizont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
J5: J_VALVE2; TerminalBlock_Phoenix_MKDS-1,5-2-5.08_1x02_P5.08mm_Horizont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
J6: J_VALVE3; TerminalBlock_Phoenix_MKDS-1,5-2-5.08_1x02_P5.08mm_Horizont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
J7: J_VALVE4; TerminalBlock_Phoenix_MKDS-1,5-2-5.08_1x02_P5.08mm_Horizont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
Q2, Q3, Q4, Q5: AO3400A; SOT-23
R9, R11, R13, R15: 100; R_0603_1608Metric
R10, R12, R14, R16: 100k; R_0603_1608Metric

Connections:
/valves/VALVE1_G: Q2.1 (G), R9.2, R10.1
/valves/VALVE1_RET: D5.2 (A), J4.2, Q2.3 (D)
/valves/VALVE2_G: Q3.1 (G), R11.2, R12.1
/valves/VALVE2_RET: D6.2 (A), J5.2, Q3.3 (D)
/valves/VALVE3_G: Q4.1 (G), R13.2, R14.1
/valves/VALVE3_RET: D7.2 (A), J6.2, Q4.3 (D)
/valves/VALVE4_G: Q5.1 (G), R15.2, R16.1
/valves/VALVE4_RET: D8.2 (A), J7.2, Q5.3 (D)
GND: C15.2, Q2.2 (S), Q3.2 (S), Q4.2 (S), Q5.2 (S), R10.2, R12.2, R14.2, R16.2; also elsewhere on the board
V12: C15.1, D5.1 (K), D6.1 (K), D7.1 (K), D8.1 (K), J4.1, J5.1, J6.1, J7.1; also elsewhere on the board
VALVE1: R9.1; also elsewhere on the board
VALVE2: R11.1; also elsewhere on the board
VALVE3: R13.1; also elsewhere on the board
VALVE4: R15.1; also elsewhere on the board

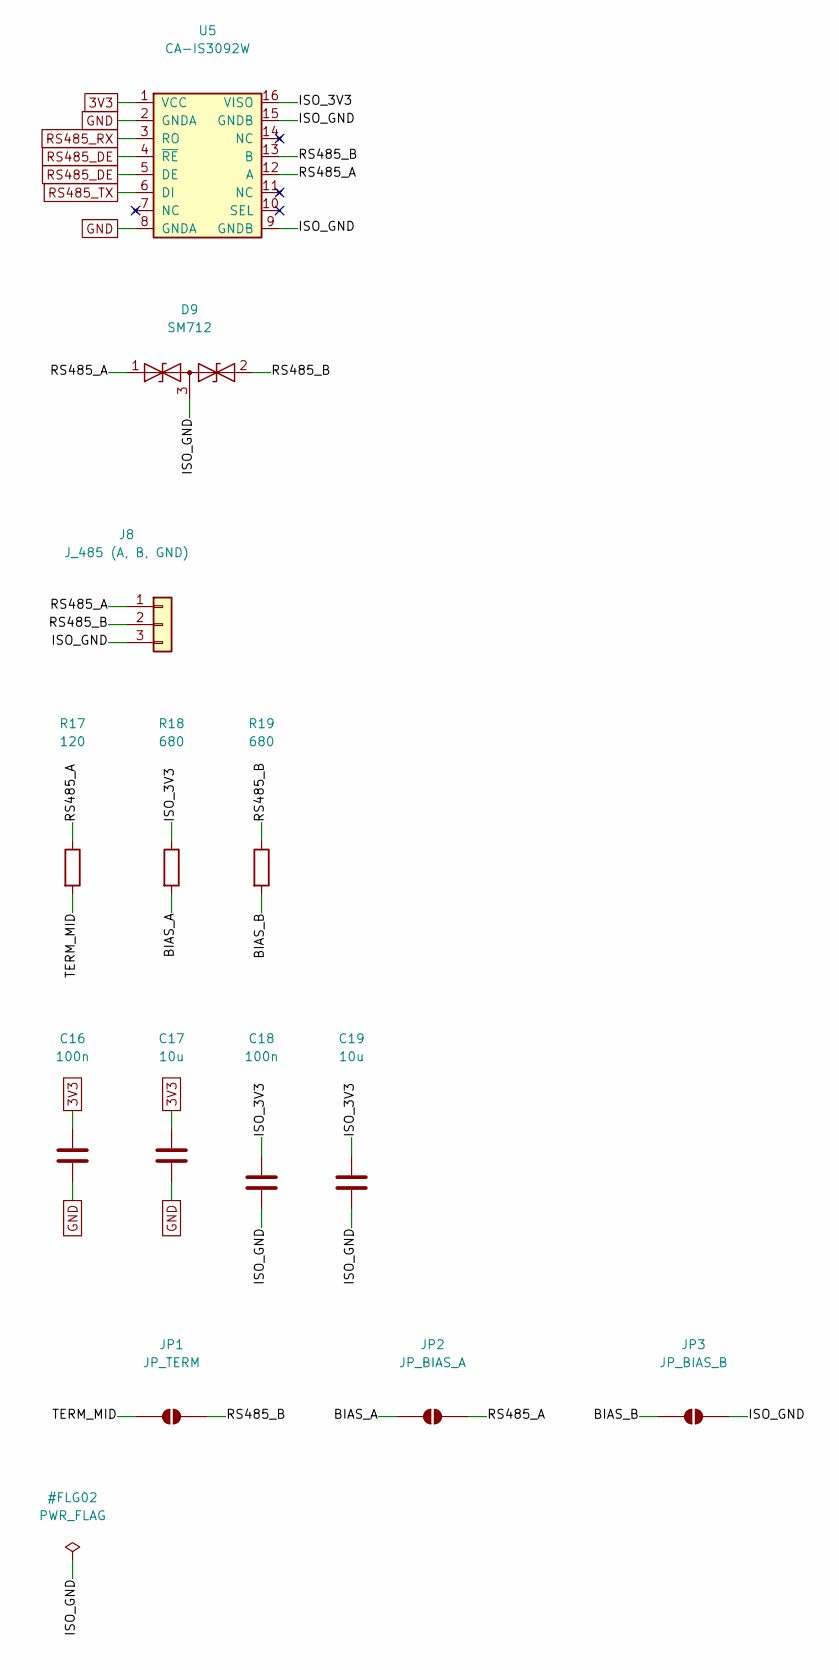
[picture p37: schematic valve_controller_rs485.kicad_sch, rs485]

Parts:
C16, C18: 100n; C_0603_1608Metric
C17, C19: 10u; C_1206_3216Metric
D9: SM712; SOT-23
J8: J_485 (A, B, GND); TerminalBlock_Phoenix_PT-1,5-3-3.5-H_1x03_P3.50mm_Horizontal
JP1: JP_TERM; SolderJumper-2_P1.3mm_Open_Pad1.0x1.5mm
JP2: JP_BIAS_A; SolderJumper-2_P1.3mm_Open_Pad1.0x1.5mm
JP3: JP_BIAS_B; SolderJumper-2_P1.3mm_Open_Pad1.0x1.5mm
R17: 120; R_0603_1608Metric
R18, R19: 680; R_0603_1608Metric
U5: CA-IS3092W; SOIC-16W_7.5x10.3mm_P1.27mm

Connections:
3V3: C16.1, C17.1, U5.1 (VCC); also elsewhere on the board
/rs485/BIAS_A: JP2.1 (A), R18.2
/rs485/BIAS_B: JP3.1 (A), R19.2
/rs485/ISO_3V3: C18.1, C19.1, R18.1, U5.16 (VISO)
/rs485/ISO_GND: C18.2, C19.2, D9.3 (common), J8.3, JP3.2 (B), U5.9 (GNDB), U5.15 (GNDB)
/rs485/RS485_A: D9.1 (A1), J8.1, JP2.2 (B), R17.1, U5.12 (A)
/rs485/RS485_B: D9.2 (A2), J8.2, JP1.2 (B), R19.1, U5.13 (B)
/rs485/TERM_MID: JP1.1 (A), R17.2
GND: C16.2, C17.2, U5.2 (GNDA), U5.8 (GNDA); also elsewhere on the board
RS485_DE: U5.4 (~RE), U5.5 (DE); also elsewhere on the board
RS485_RX: U5.3 (RO); also elsewhere on the board
RS485_TX: U5.6 (DI); also elsewhere on the board

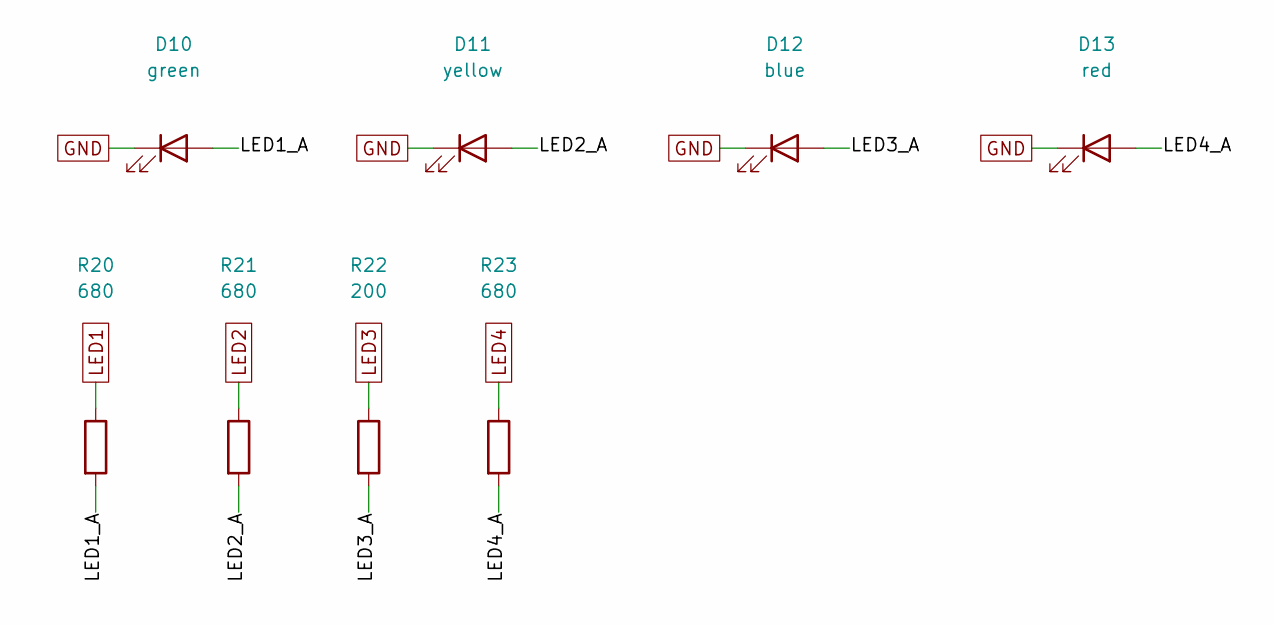
[picture p38: schematic valve_controller_leds.kicad_sch, leds]

Parts:
D10: green; LED_0603_1608Metric
D11: yellow; LED_0603_1608Metric
D12: blue; LED_0603_1608Metric
D13: red; LED_0603_1608Metric
R20, R21, R23: 680; R_0603_1608Metric
R22: 200; R_0603_1608Metric

Connections:
/leds/LED1_A: D10.2 (A), R20.2
/leds/LED2_A: D11.2 (A), R21.2
/leds/LED3_A: D12.2 (A), R22.2
/leds/LED4_A: D13.2 (A), R23.2
GND: D10.1 (K), D11.1 (K), D12.1 (K), D13.1 (K); also elsewhere on the board
LED1: R20.1; also elsewhere on the board
LED2: R21.1; also elsewhere on the board
LED3: R22.1; also elsewhere on the board
LED4: R23.1; also elsewhere on the board

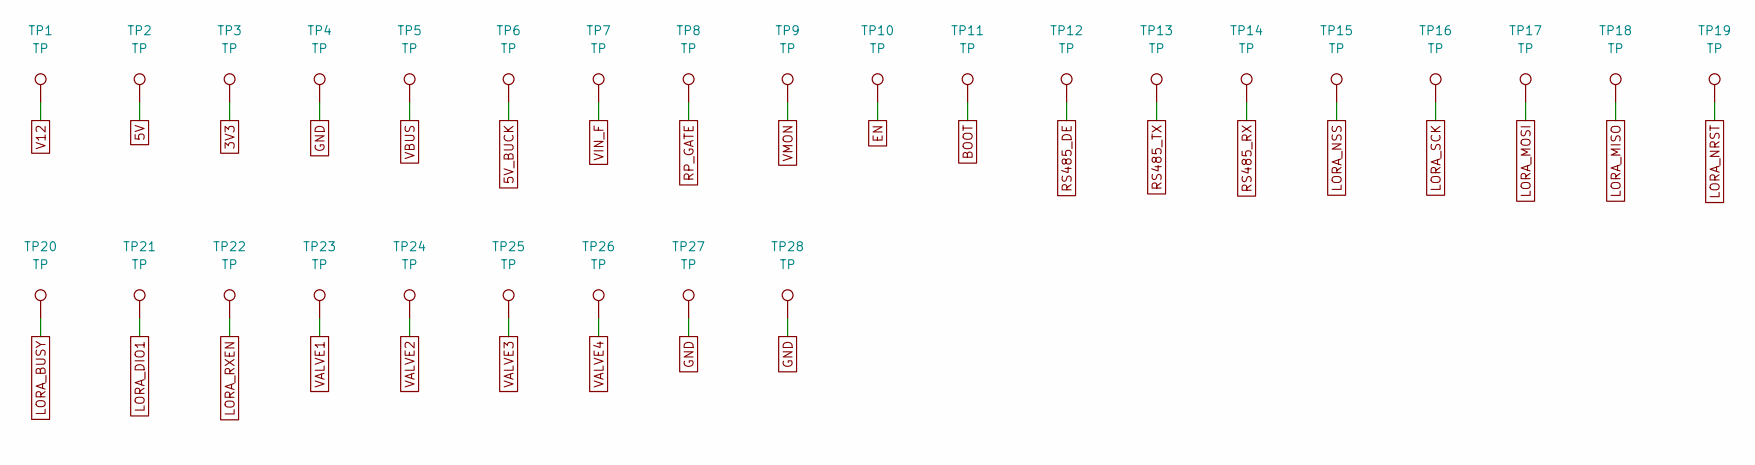
[picture p39: schematic valve_controller_test_points.kicad_sch, test_points]

Parts:
TP1, TP2, TP3, TP4: TP; TestPoint_Pad_D1.5mm
TP5, TP6, TP7, TP8, TP9, TP10, TP11, TP12, TP13, TP14, TP15, TP16, TP17, TP18, TP19, TP20, TP21, TP22, TP23, TP24, TP25, TP26, TP27, TP28: TP; TestPoint_Pad_D1.0mm

Connections:
3V3: TP3.1; also elsewhere on the board
5V: TP2.1; also elsewhere on the board
5V_BUCK: TP6.1; also elsewhere on the board
BOOT: TP11.1; also elsewhere on the board
EN: TP10.1; also elsewhere on the board
GND: TP4.1, TP27.1, TP28.1; also elsewhere on the board
LORA_BUSY: TP20.1; also elsewhere on the board
LORA_DIO1: TP21.1; also elsewhere on the board
LORA_MISO: TP18.1; also elsewhere on the board
LORA_MOSI: TP17.1; also elsewhere on the board
LORA_NRST: TP19.1; also elsewhere on the board
LORA_NSS: TP15.1; also elsewhere on the board
LORA_RXEN: TP22.1; also elsewhere on the board
LORA_SCK: TP16.1; also elsewhere on the board
RP_GATE: TP8.1; also elsewhere on the board
RS485_DE: TP12.1; also elsewhere on the board
RS485_RX: TP14.1; also elsewhere on the board
RS485_TX: TP13.1; also elsewhere on the board
V12: TP1.1; also elsewhere on the board
VALVE1: TP23.1; also elsewhere on the board
VALVE2: TP24.1; also elsewhere on the board
VALVE3: TP25.1; also elsewhere on the board
VALVE4: TP26.1; also elsewhere on the board
VBUS: TP5.1; also elsewhere on the board
VIN_F: TP7.1; also elsewhere on the board
VMON: TP9.1; also elsewhere on the board

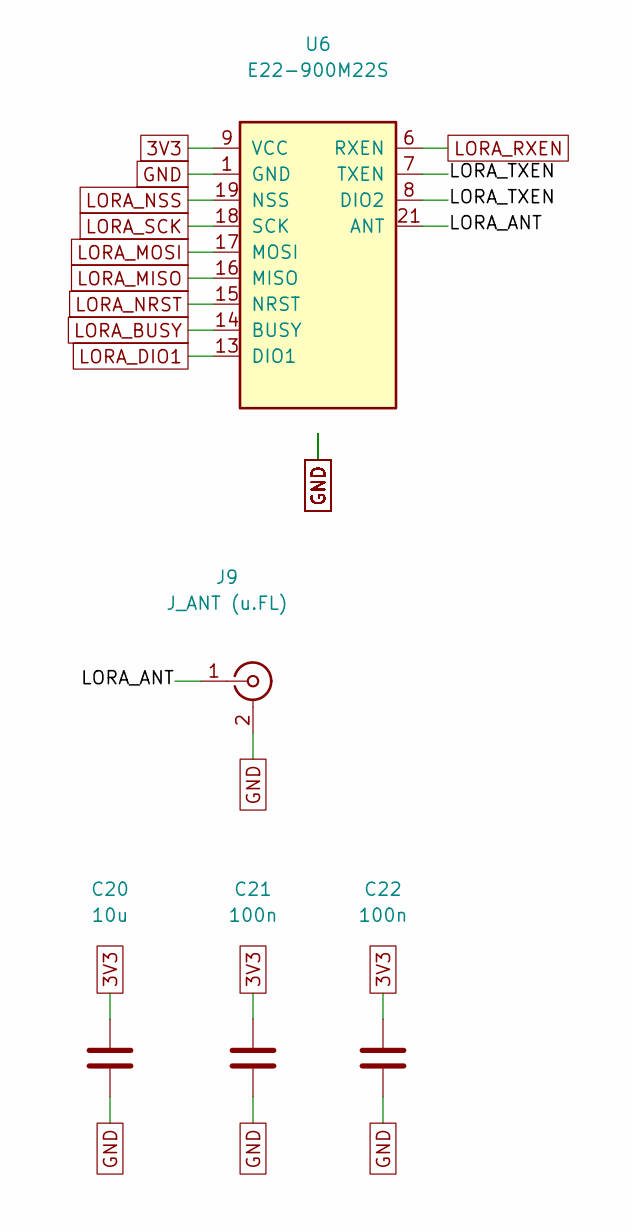
[picture p40: schematic valve_controller_lora.kicad_sch, lora]

Parts:
C20: 10u; C_1206_3216Metric
C21, C22: 100n; C_0603_1608Metric
J9: J_ANT (u.FL); U.FL_Hirose_U.FL-R-SMT-1_Vertical
U6: E22-900M22S

Connections:
3V3: C20.1, C21.1, C22.1, U6.9 (VCC); also elsewhere on the board
/lora/LORA_ANT: J9.1 (In), U6.21 (ANT)
/lora/LORA_TXEN: U6.7 (TXEN), U6.8 (DIO2)
GND: C20.2, C21.2, C22.2, J9.2 (Ext), U6.1 (GND), U6.2 (GND), U6.3 (GND), U6.4 (GND), U6.5 (GND), U6.10 (GND), U6.11 (GND), U6.12 (GND), U6.20 (GND), U6.22 (GND); also elsewhere on the board
LORA_BUSY: U6.14 (BUSY); also elsewhere on the board
LORA_DIO1: U6.13 (DIO1); also elsewhere on the board
LORA_MISO: U6.16 (MISO); also elsewhere on the board
LORA_MOSI: U6.17 (MOSI); also elsewhere on the board
LORA_NRST: U6.15 (NRST); also elsewhere on the board
LORA_NSS: U6.19 (NSS); also elsewhere on the board
LORA_RXEN: U6.6 (RXEN); also elsewhere on the board
LORA_SCK: U6.18 (SCK); also elsewhere on the board

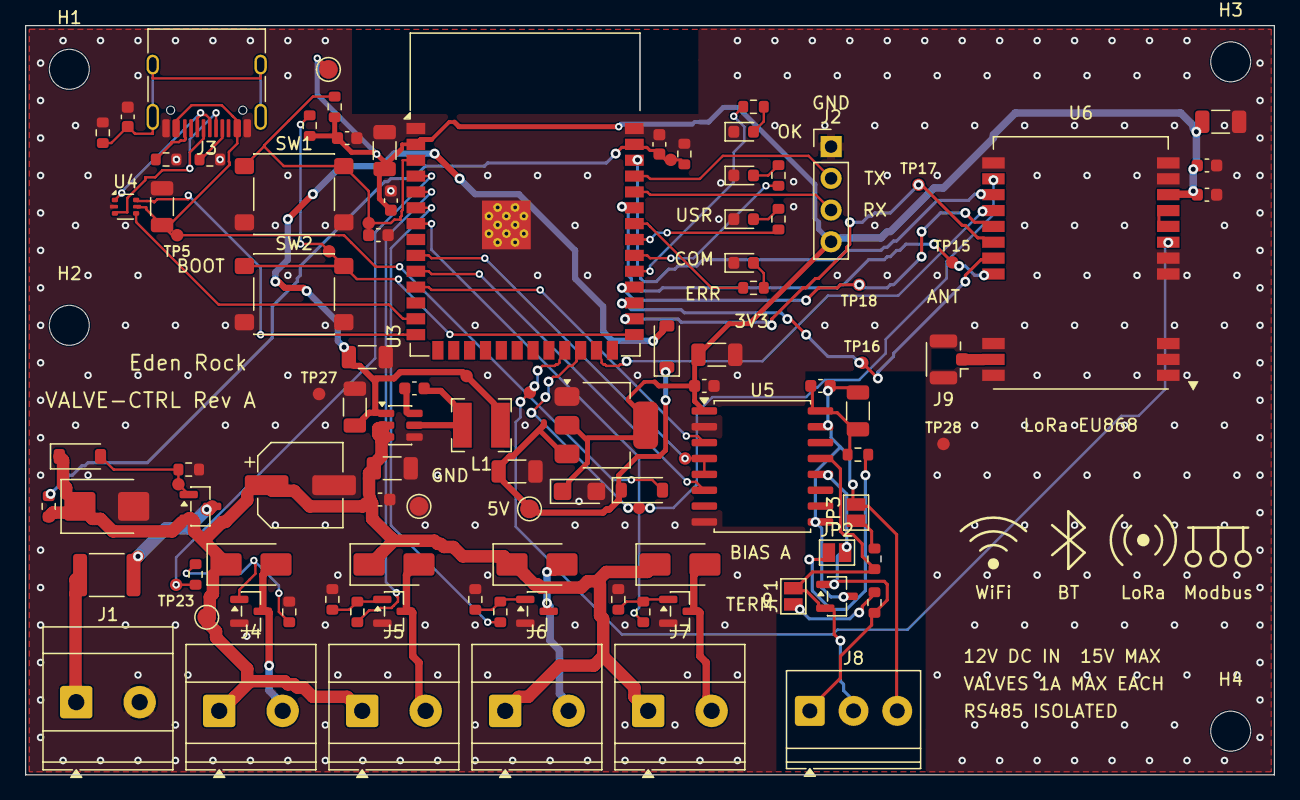
[picture p41: board valve_controller.kicad_pcb from above]

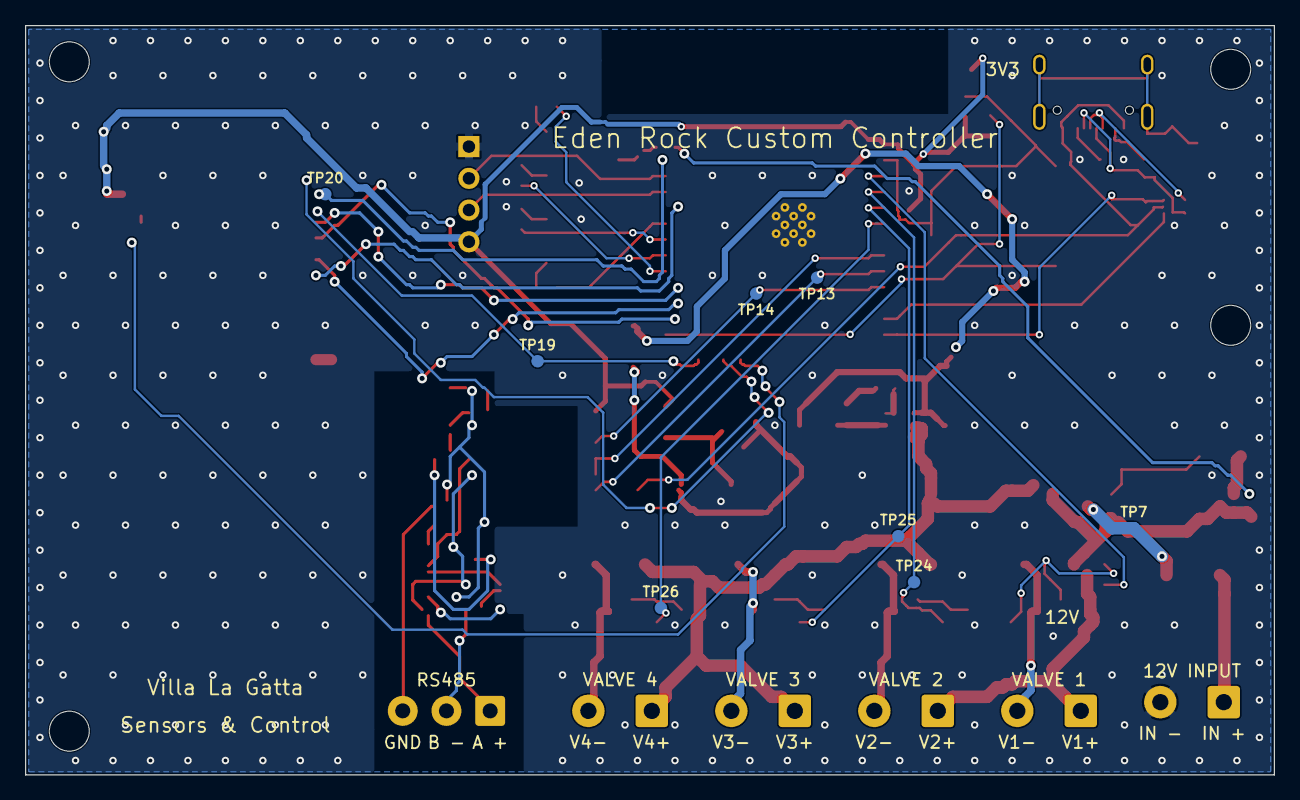
[picture p42: board valve_controller.kicad_pcb from below]

Board: 2 copper layers, 100.0 x 60.0 mm, 117 parts (8 on the bottom side), 63 nets.

Other parts of the board:
H1, H2, H3: M3; MountingHole_3.2mm_M3
H4: MountingHole_3.2mm_M3
