mtilocca/sprinkler-valve-controller/(commit log)

2026-10-31 Starting point: copy of sprinkler-mppt-pcb (MPPT version, Rev A draft)
    The MPPT charger, panel/battery sensing and related parts will be removed
    from this copy: PV and MPPT move to a separate module.
    [BOM_JLCPCB_import.csv, BOM_sprinkler_mppt.csv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]
2026-10-31 New schematic: 12 V in, ESP32-S3, 4 valves, isolated RS485 (CA-IS3092W)
    MPPT, PV/battery sensing, gate driver and the extra regulators removed.
    5 V buck is now AP63205 (fixed), input has PTC fuse, P-FET reverse
    protection and TVS, 12 V monitor on GPIO1. Datasheet pin checks asserted
    in the generator. ERC clean.
    [BOM_JLCPCB_import.csv, BOM_sprinkler_mppt.csv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]
2026-10-31 Layout: 70 x 60 mm 2-layer placement (no routing yet)
    Terminals along the bottom edge (12 V in + 4 valves), RS485 terminal on the
    right edge with the isolated transceiver and bus-side parts in a strip right
    of the chip centre line, ESP32 antenna on the top edge, USB-C top left.
    All 84 parts on the top side. Antenna and RS485 isolation keep-outs added.
    [valve_controller.kicad_pcb, valve_controller_rs485.kicad_sch, valve_controller_test_points.kicad_sch]
2026-10-31 Pre-route power nets (V12 1.0 mm, valve returns 0.6 mm, 5 V rails 0.5 mm)
    [valve_controller.kicad_pcb]
2026-10-31 Route signals with Freerouting (GND left for pours)
    All signal nets routed; the 51 remaining unconnected items are GND pads,
    which the top and bottom GND pours will connect.
    [valve_controller.kicad_pcb]
2026-10-31 GND pours on both layers with stitching vias; bus side re-routed clear of the isolation barrier
    [valve_controller.kicad_pcb]
2026-10-31 Silkscreen, BOM draft, fab files (Gerbers, drill, CPL), README with specs and costs
    [BOM_JLCPCB_import.csv, BOM_valve_controller.csv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]
2026-10-31 More silkscreen: valve names, RS485 and input polarity, Eden Rock Custom Controller
    [valve_controller-B_Cu.gbl, valve_controller-B_Mask.gbs, valve_controller-B_Silkscreen.gbo, valve_controller-Edge_Cuts.gm1, valve_controller-F_Cu.gtl, valve_controller-F_Mask.gts, valve_controller-F_Paste.gtp, valve_controller-F_Silkscreen.gto]
2026-10-31 Parts check: LCSC numbers in the BOM, inductor label fixed (4.7u Isat>=2A), parts-check doc
    [BOM_JLCPCB_import.csv, BOM_valve_controller.csv, valve_controller.kicad_pcb, valve_controller_aux_power.kicad_sch]
2026-10-31 Fabrication package: Gerbers, drill, CPL, JLCPCB BOM, assembly drawings, order notes
    ESP32 pad vias enlarged to 0.3 mm (2-layer minimum). THT parts removed from the JLCPCB BOM.
    [BOM_JLCPCB_import.csv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]
2026-11-01 Widen the short 0.2 mm stubs in the 12 V input path to 1.0 mm; document valve current limits; regenerate Gerbers
    [valve_controller-B_Cu.gbl, valve_controller-B_Mask.gbs, valve_controller-B_Silkscreen.gbo, valve_controller-Edge_Cuts.gm1, valve_controller-F_Cu.gtl, valve_controller-F_Mask.gts, valve_controller-F_Paste.gtp, valve_controller-F_Silkscreen.gto]
2026-11-01 Note the reference valve (12 V DC, 6.5 W, 540 mA) in the requirements
2026-11-01 Document the single-valve ceiling and the valves-on-at-once rule
2026-11-01 Shopping list for the hand-soldered parts and bring-up items
2026-11-01 BOM: list every designator (JLCPCB cannot read ranges like Q2-Q5)
    [BOM_JLCPCB_import.csv, BOM_valve_controller.csv]
2026-11-01 LED resistors for green and yellow: 620 to 680 ohm (basic part, saves an extended-part fee)
    [BOM_JLCPCB_import.csv, BOM_valve_controller.csv, valve_controller.kicad_pcb, valve_controller_leds.kicad_sch]
2026-11-01 BOM and CPL include the through-hole parts (JLCPCB solders them, Standard assembly)
    [BOM_JLCPCB_import.csv, BOM_valve_controller.csv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]
2026-11-01 LDO: AP7361C (out of stock) -> AMS1117-3.3 with 22 uF tantalum output; SMT-only BOM and CPL again (terminals and header soldered by hand); docs
    [BOM_JLCPCB_import.csv, BOM_valve_controller.csv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]
2026-11-01 BOM: swap out-of-stock C15/D2, add D1/C8/D3-D4 LCSC numbers; Gerber zip renamed Rev B
    [BOM_JLCPCB_import.csv, BOM_valve_controller.csv]
2026-11-01 CPL: shift U3 4 mm to match JLCPCB model origin
    [CPL_valve_controller.csv]
2026-11-01 CPL: rotate U2 (180) and U5 (270) to match JLCPCB models
    [CPL_valve_controller.csv]
2026-11-01 Add USB-C 3D model (KiCad demo STEP) and point J3 at it
    [USB_C_HRO_TYPE-C-31-M-12.step, valve_controller.kicad_pcb]
2026-11-01 Add 1812 body model for F1 (KiCad library has no Fuse_1812 model)
    [Fuse_1812_4532Metric.step, valve_controller.kicad_pcb]
2026-11-01 Rev C: LoRa radio (E22-900M22S, u.FL antenna), board 100x60, new fab package
    Single-channel EU868 radio on SPI; schematic ERC clean, board DRC 0 errors / 0 unconnected with schematic parity.
    [BOM_JLCPCB_import.csv, BOM_valve_controller.csv, E22-900M22S.step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]
2026-11-01 Silkscreen: Villa La Gatta Sensors & Control (bottom right); Rev C Gerbers regenerated
    [valve_controller-B_Cu.gbl, valve_controller-B_Mask.gbs, valve_controller-B_Silkscreen.gbo, valve_controller-Edge_Cuts.gm1, valve_controller-F_Cu.gtl, valve_controller-F_Mask.gts, valve_controller-F_Paste.gtp, valve_controller-F_Silkscreen.gto]
2026-11-01 J8 (RS485 terminal) rotated to the bottom edge; bus nets re-routed; Gerbers regenerated
    [valve_controller-B_Cu.gbl, valve_controller-B_Mask.gbs, valve_controller-B_Silkscreen.gbo, valve_controller-Edge_Cuts.gm1, valve_controller-F_Cu.gtl, valve_controller-F_Mask.gts, valve_controller-F_Paste.gtp, valve_controller-F_Silkscreen.gto]
2026-11-01 Silkscreen: Villa La Gatta text moved to the bottom layer, technical ratings text on top
    [valve_controller-B_Cu.gbl, valve_controller-B_Mask.gbs, valve_controller-B_Silkscreen.gbo, valve_controller-Edge_Cuts.gm1, valve_controller-F_Cu.gtl, valve_controller-F_Mask.gts, valve_controller-F_Paste.gtp, valve_controller-F_Silkscreen.gto]
2026-11-01 Re-route LoRa signals and 3V3 around the E22 body; review notes; Gerbers regenerated
    [valve_controller-B_Cu.gbl, valve_controller-B_Mask.gbs, valve_controller-B_Silkscreen.gbo, valve_controller-Edge_Cuts.gm1, valve_controller-F_Cu.gtl, valve_controller-F_Mask.gts, valve_controller-F_Paste.gtp, valve_controller-F_Silkscreen.gto]
2026-11-01 Move mounting hole H3 from mid-board to the top right corner; Gerbers regenerated
    [valve_controller-B_Cu.gbl, valve_controller-B_Mask.gbs, valve_controller-B_Silkscreen.gbo, valve_controller-Edge_Cuts.gm1, valve_controller-F_Cu.gtl, valve_controller-F_Mask.gts, valve_controller-F_Paste.gtp, valve_controller-F_Silkscreen.gto]
2026-11-01 Schematic PDF regenerated (LoRa sheet included)
2026-11-03 Silkscreen: WiFi, Bluetooth, LoRa and Modbus capability icons above the ratings text; Gerbers regenerated
    [valve_controller-B_Cu.gbl, valve_controller-B_Mask.gbs, valve_controller-B_Silkscreen.gbo, valve_controller-Edge_Cuts.gm1, valve_controller-F_Cu.gtl, valve_controller-F_Mask.gts, valve_controller-F_Paste.gtp, valve_controller-F_Silkscreen.gto]
2026-11-03 finished board
2026-11-11 finished board and docs
    [BOM_JLCPCB_import.csv, BOM_valve_controller.csv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]
